m3x1m0m/SwakeUp/README.md

# SwakeUp
A device to wake you up in Sweden (because it is so dark in the winter).
