m3x1m0m/SwakeUp/documents/report/report.tex

%%%%%%%%%%%%%%%%%%%%%%%%%%%%%%%%%%%%%%%%%%%%%%%%%%%%%%%%%%%%%%%%%%%%%%%%%%%%%%%%%%%%%%
%% Author:      Maximilian Stiefel
%% Date:        31.05.2017
%% University:  Uppsala Universitet
%% Department:  Institutionen för informationsteknologi 
%% Course:      Programming Embedded Systems
%% Project:     Swakeup
%%%%%%%%%%%%%%%%%%%%%%%%%%%%%%%%%%%%%%%%%%%%%%%%%%%%%%%%%%%%%%%%%%%%%%%%%%%%%%%%%%%%%%

\documentclass{report}

%%%%%%%%%%%%%%%%%%%%%%%%%%%%%%%%%%%%%%%%%%%%%%%%%%%%%%%%%%%%%%%%%%%%%%%%%%%%%%%%%%%%%%
% Preamble
%%%%%%%%%%%%%%%%%%%%%%%%%%%%%%%%%%%%%%%%%%%%%%%%%%%%%%%%%%%%%%%%%%%%%%%%%%%%%%%%%%%%%%

% Encoding of the input
\usepackage[utf8]{inputenc}

% Geometry stuff
\usepackage[head=24pt,a4paper,lmargin={2.5cm},rmargin={2.5cm},tmargin={2.5cm},
bmargin={2.5cm}]{geometry}

% For graphics
\usepackage{graphicx}

% For code highlighting
\usepackage{minted}

% For shaded
\usepackage{xcolor}
\usepackage{framed}
\definecolor{shadecolor}{gray}{0.9}

% For some symbols
\usepackage{textcomp}
%\usepackage{eurosans}

% For math
\usepackage{amssymb}
\usepackage{amsmath}

\setlength{\parindent}{0em} 

% For title formatting 
\usepackage{titlesec} 

\titleformat%
{\chapter}%
[block]%
{\bfseries\Huge}%
{\thechapter\hspace{1cm}}%
{0pt}%
{\bfseries\Huge}%

% For SI units.
\usepackage{siunitx}

% Input definition macros
\input{mydefs.tex}

\usepackage{hyperref}
\hypersetup{
	plainpages=false,
	unicode=false,
	pdftoolbar=true,
	pdfmenubar=true,
	pdffitwindow=false,
	pdfstartview={FitH},
	pdftitle={\mytitle},
	pdfauthor={\myauthora ,\space\myauthorb ,\space\myauthorc},
	pdfsubject={\mytypeofwork\space\myduedate},
	pdfcreator={\myauthora ,\space\myauthorb ,\space\myauthorc},
	pdfproducer={\myauthora ,\space\myauthorb ,\space\myauthorc},
	pdfkeywords={\mykeywords},
	pdfnewwindow=true,
	pdfborder={0 0 0},
	colorlinks=false,
	linkcolor=black,
	citecolor=black,
	filecolor=black,
	urlcolor=cyan
}	

\newcommand{\newpar}{\vspace{1em}\\}
\newcommand{\myemph}[1]{\textsl{#1}}

% For PDFs
\usepackage{pdfpages}

% Header and footer
\usepackage{fancyhdr}
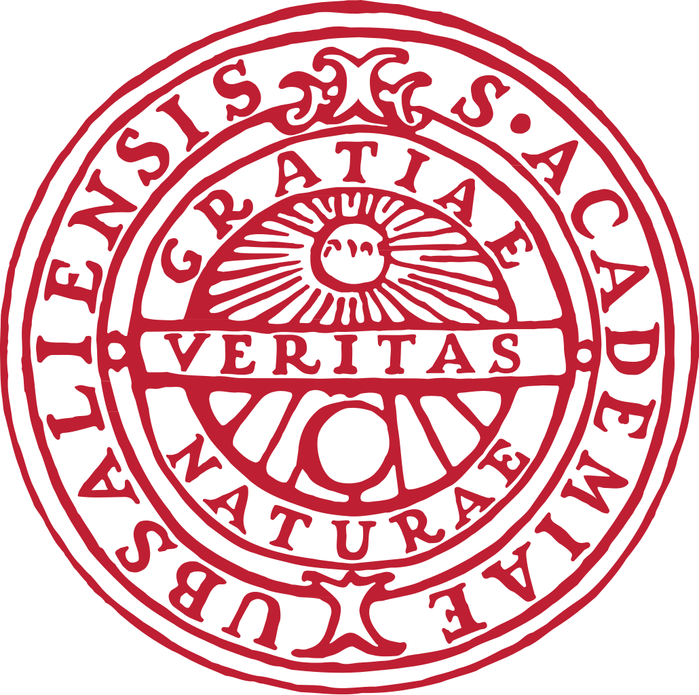
[picture p1: documents/report/fig/uppsla_university.png]
\lhead{\ifnum\value{chapter}>0  \fi}
\chead{}
\rhead{\ifnum\value{chapter}>0 {\rightmark}\\\textcolor{gray}{\leftmark} \fi}
\lfoot{}
\cfoot{\ifnum\value{chapter}>0 \thepage \fi}
\rfoot{}
\setlength{\headheight}{1cm}

% For quotes
\usepackage[autostyle]{csquotes}
\usepackage[style=ieee,backend=bibtex]{biblatex}
\addbibresource{literature.bib}

%For tables
\usepackage{tabularx}

\begin{document}

%%%%%%%%%%%%%%%%%%%%%%%%%%%%%%%%%%%%%%%%%%%%%%%%%%%%%%%%%%%%%%%%%%%%%%%%%%%%%%%%%%%%%%
% Titlepage
%%%%%%%%%%%%%%%%%%%%%%%%%%%%%%%%%%%%%%%%%%%%%%%%%%%%%%%%%%%%%%%%%%%%%%%%%%%%%%%%%%%%%%
\input{titlepage.tex}

\newcounter{roman}
\pagenumbering{Roman}

\pagestyle{fancy}

%%%%%%%%%%%%%%%%%%%%%%%%%%%%%%%%%%%%%%%%%%%%%%%%%%%%%%%%%%%%%%%%%%%%%%%%%%%%%%%%%%%%%%
% TOC etc.
%%%%%%%%%%%%%%%%%%%%%%%%%%%%%%%%%%%%%%%%%%%%%%%%%%%%%%%%%%%%%%%%%%%%%%%%%%%%%%%%%%%%%%
\tableofcontents
\listoffigures
\newpage
\listoftables

\newpage
\setcounter{roman}{\value{page}}
\pagenumbering{arabic}
\setcounter{page}{1}

%%%%%%%%%%%%%%%%%%%%%%%%%%%%%%%%%%%%%%%%%%%%%%%%%%%%%%%%%%%%%%%%%%%%%%%%%%%%%%%%%%%%%%
% Introduction
%%%%%%%%%%%%%%%%%%%%%%%%%%%%%%%%%%%%%%%%%%%%%%%%%%%%%%%%%%%%%%%%%%%%%%%%%%%%%%%%%%%%%%

\input{./doc/introduction.tex}

%%%%%%%%%%%%%%%%%%%%%%%%%%%%%%%%%%%%%%%%%%%%%%%%%%%%%%%%%%%%%%%%%%%%%%%%%%%%%%%%%%%%%%
% Background and Analysis
%%%%%%%%%%%%%%%%%%%%%%%%%%%%%%%%%%%%%%%%%%%%%%%%%%%%%%%%%%%%%%%%%%%%%%%%%%%%%%%%%%%%%%

\input{./doc/background.tex}

%%%%%%%%%%%%%%%%%%%%%%%%%%%%%%%%%%%%%%%%%%%%%%%%%%%%%%%%%%%%%%%%%%%%%%%%%%%%%%%%%%%%%%
% Design
%%%%%%%%%%%%%%%%%%%%%%%%%%%%%%%%%%%%%%%%%%%%%%%%%%%%%%%%%%%%%%%%%%%%%%%%%%%%%%%%%%%%%%

\input{./doc/design.tex}

%%%%%%%%%%%%%%%%%%%%%%%%%%%%%%%%%%%%%%%%%%%%%%%%%%%%%%%%%%%%%%%%%%%%%%%%%%%%%%%%%%%%%%
% Implementation
%%%%%%%%%%%%%%%%%%%%%%%%%%%%%%%%%%%%%%%%%%%%%%%%%%%%%%%%%%%%%%%%%%%%%%%%%%%%%%%%%%%%%%

\input{./doc/implementation.tex}

%%%%%%%%%%%%%%%%%%%%%%%%%%%%%%%%%%%%%%%%%%%%%%%%%%%%%%%%%%%%%%%%%%%%%%%%%%%%%%%%%%%%%%
% Evaluation
%%%%%%%%%%%%%%%%%%%%%%%%%%%%%%%%%%%%%%%%%%%%%%%%%%%%%%%%%%%%%%%%%%%%%%%%%%%%%%%%%%%%%%

\input{./doc/evaluation.tex}

%%%%%%%%%%%%%%%%%%%%%%%%%%%%%%%%%%%%%%%%%%%%%%%%%%%%%%%%%%%%%%%%%%%%%%%%%%%%%%%%%%%%%%
% Conclusion
%%%%%%%%%%%%%%%%%%%%%%%%%%%%%%%%%%%%%%%%%%%%%%%%%%%%%%%%%%%%%%%%%%%%%%%%%%%%%%%%%%%%%%

\input{./doc/conclusion.tex}

%%%%%%%%%%%%%%%%%%%%%%%%%%%%%%%%%%%%%%%%%%%%%%%%%%%%%%%%%%%%%%%%%%%%%%%%%%%%%%%%%%%%%%
% Bibliography and Appendix
%%%%%%%%%%%%%%%%%%%%%%%%%%%%%%%%%%%%%%%%%%%%%%%%%%%%%%%%%%%%%%%%%%%%%%%%%%%%%%%%%%%%%%

\clearpage
\pagenumbering{Roman}
\setcounter{page}{\value{roman}}
\pagestyle{empty}

\printbibliography[heading=bibintoc]

%%%%%%%%%%%%%%%%%%%%%%%%%%%%%%%%%%%%%%%%%%%%%%%%%%%%%%%%%%%%%%%%%%%%%%%%%%%%%%%%%%%%%%
% Appendix
%%%%%%%%%%%%%%%%%%%%%%%%%%%%%%%%%%%%%%%%%%%%%%%%%%%%%%%%%%%%%%%%%%%%%%%%%%%%%%%%%%%%%%
\appendix
% Introduce new geometry to be able to have more space for appendix
\newgeometry{lmargin={2.5cm},rmargin={2.5cm},tmargin={0cm},bmargin={1,5cm}}
\includepdf[pages={1},scale=0.8,pagecommand=\chapter{Schematics Logic Board}\label{append:logic}]{./fig/logic.pdf}
\includepdf[pages={1},scale=0.8,pagecommand=\chapter{Schematics Power Board}\label{append:power}]{./fig/power.pdf}
\includepdf[pages={2-},scale=0.8,pagecommand={}]{./fig/power.pdf}
\chapter{USART interrupt generation}
\label{append:usartinterruptgen}
\begin{minted}[baselinestretch=1, fontsize=\small, linenos,frame=single,framesep=5pt]{C}
#define USARTRXCISR(NAME, PORT, USART_ID, REC_FC)            \
ISR(NAME##_RXC_vect) {                             \
	uint8_t read = PORT.DATA;                    \
	if (writeInBuf(read, &PORT)) {               \
	REC_FC(read);                                   \
	uint8_t i = 0;                              \
	for (; i < UART_MAX_DELIMITERS; i++) {      \
		if (delimiters[USART_ID][i].delimiter != 0) {  \
			delimiters[USART_ID][i].length++;          \
			if (read == delimiters[USART_ID][i].delimiter) {   \
				delimiters[USART_ID][i].port = &PORT;       \
				event_fire(&EVENT_UART_DELIMITER,	\
				SYSTEM_ADDRESS_CAST (&delimiters[USART_ID][i])); \
				}   \
			}   \
		}   \
	} else {/*buffer full */    \
		CP_PORT.CTRLA &= ~(USART_RXCINTLVL_LO_gc);  \
	}   \
}

#define USARTDREISR(NAME, PORT, USART_ID)\
ISR(NAME##_DRE_vect) {             \
	uint8_t size = uartStatus[USART_ID].outBuffer_size;    \
	if (size > 0) { \
		if (softlock(USART_ID)) {\
			uint8_t tail = uartStatus[USART_ID].outBuffer_tail;\
			PORT.DATA = outBuffer[USART_ID][tail];  \
			uartStatus[USART_ID].outBuffer_size--; \
			tail++; \
			if (tail >= UART_MAX_OUT_BUFFER) tail = 0;\
			uartStatus[USART_ID].outBuffer_tail = tail;\
			unlock(USART_ID);  \
		}\
	} else {\
		sending[USART_ID] = 0;\
		PORT.CTRLA &= ~(USART_DREINTLVL0_bm);\
	}\
}
\end{minted}
\end{document}
