m3x1m0m/SwakeUp/documents/proposal/doc/outlook.tex

Hopefully the LED driver will work with the next revision. The new boards have not arrived until the deadline. As soon as the hardware is working, the controllers will be implemented in software. 
\newpar
Aditional funtionality will be implemented e.g. connecting you calendar to the device and seing your daily agenda when you wake up. Also there is no housing yet.
