m3x1m0m/SwakeUp/documents/proposal/doc/works.tex

The hardware right now is in revision 2.0. There has been one revision before the current one. This revision has been fabricated in january 2017 and the design process began in november 2016. There were some mistakes on the first hardware revision, which were not fixable so easily, especially because of the fact, that everything is quite small. Table \ref{tab:hw} gives an overview of the current satus of the hardware.   
\begin{table}[H]
\centering
\begin{tabular}{lll}
\textbf{HW Block}  	& \textbf{Working}& \textbf{Problem}  	\\\hline
USB Charging 	& \checkmark	& 				\\
OLED Driver  	& \checkmark    & 				\\
Vcc for µC   	& \checkmark    & 				\\
IEEE 802.11   	& \checkmark    &                             	\\
USB2UART	& \checkmark	&				\\
LED Driver	&		& Wrong footprint assignment	\\
Crystal		&		& Wrong pin assignment		\\
USB DCP		&		& Further tests necessary	\\
\end{tabular}
\caption{Hardware Overview: What works? What does not?}
\label{tab:hw}
\end{table}
Table \ref{tab:sw} deals with an overview about the status of the software. 
\begin{table}[H]
\centering
\begin{tabular}{lll}
\textbf{SW Block}  	& \textbf{Working}& \textbf{Problem} 	\\\hline
UART 		& \checkmark	& 				\\
SPI	  	& \checkmark    & 				\\
EPROM   	& \checkmark    & 				\\
Timer   	& \checkmark    &                             	\\
ADC		& 		& 				\\
PWM 		&		&				\\
ESP8266		& \checkmark	& 				\\
Terminal	& \checkmark	& 				\\
SEP525F		& \checkmark	& 				\\
Wifi		& 		& 				\\
Command		& \checkmark	& 				\\
Log		& \checkmark	& 				\\
Screen		& \checkmark	& 				\\
Timekeeper	& \checkmark	& 				\\
Controller	&		&				\\
Core		& \checkmark	& 				\\
Weather		& \checkmark	&				\\
Clock		& \checkmark	&				\\
Social		& 		&				\\
\end{tabular}
\caption{Software Overview: What works? What does not?}
\label{tab:sw}
\end{table}
