m3x1m0m/SwakeUp/documents/presentation/presentation.tex

\documentclass[apectratio=169]{beamer}
\usetheme{metropolis}           % Use metropolis theme
% For PDFs
\usepackage{pdfpages}
\usepackage{minted}
\usepackage{tabularx}
\title{Swakeup}
\subtitle{More Than A Simple Wakeup Light}
\date{\today}
\author{Elmar van Rijnswou and Maximilian Stiefel}
\institute{Uppsala University}
\begin{document}
  \maketitle

\begin{frame}{Table Of Contents}
  \setbeamertemplate{section in toc}[sections numbered]
  \tableofcontents[hideallsubsections]
\end{frame}

  \section{Introduction}
  	\begin{frame}{Poka-yoke}
		\only<1>{\Large Who knows what Poka-yoke is?}
		\only<2>{
		\metroset{block=fill}
		\begin{block}{Poka-yoke (Wikipedia)}
		Poka-yoke [poka joke] is a Japanese term that means
		"mistake-proofing" or "inadvertent error prevention".
		\end{block}
		}
	\end{frame}
	\begin{frame}{Background}
		\begin{figure}
        		\centering
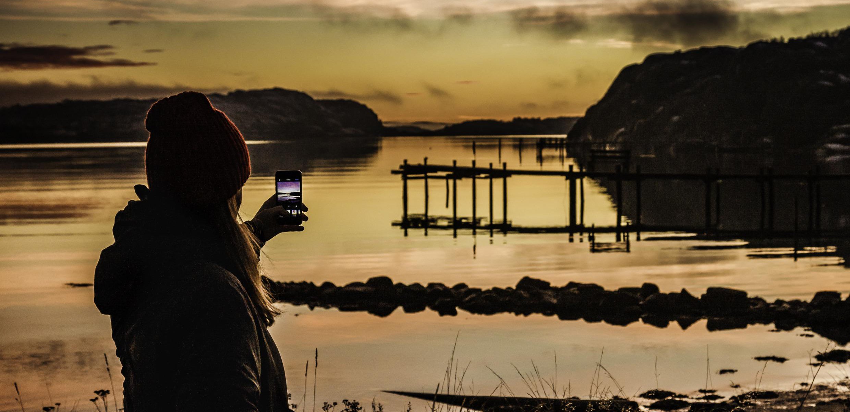
[picture p9: documents/presentation/fig/darkness.jpg]
                	
			\caption{According to Sveriges Radio ”many Swedes suffer
		from the winter blues or seasonal affective disorder”.
		Image Source: Visitsweden}
		\end{figure}
	\end{frame}

  	\begin{frame}{System Requirements}
		\begin{itemize}
			\item<1-> Wakeup light which is a part of the \textit{IoT}
			\item<2-> Swakeup \ensuremath{\rightarrow} engl. "Swedish Wakeup Light"
			\item<3-> Wakes up, displays time, weather, mails, facebook
			\item<4-> Smart, small, USB charger included
			\item<5-> \alert<5->{Spends happiness}
		\end{itemize}
  	\end{frame}
  	\begin{frame}{System Overview}	
		\begin{figure}
			\centering
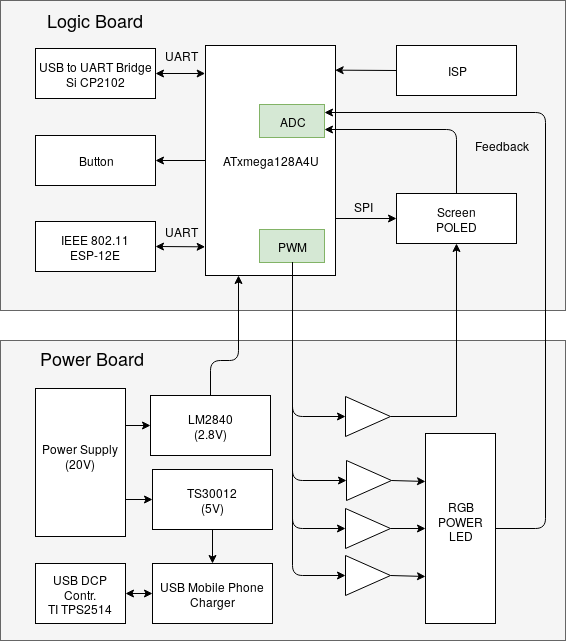
[picture p10: documents/block/block.png]
			\only<2>{}
			\only<1>{}
			\caption{System Overview}
		\end{figure}
	\end{frame}
  
  \section{Hardware}
  	\begin{frame}{Power Board}
		\begin{figure}
			\centering
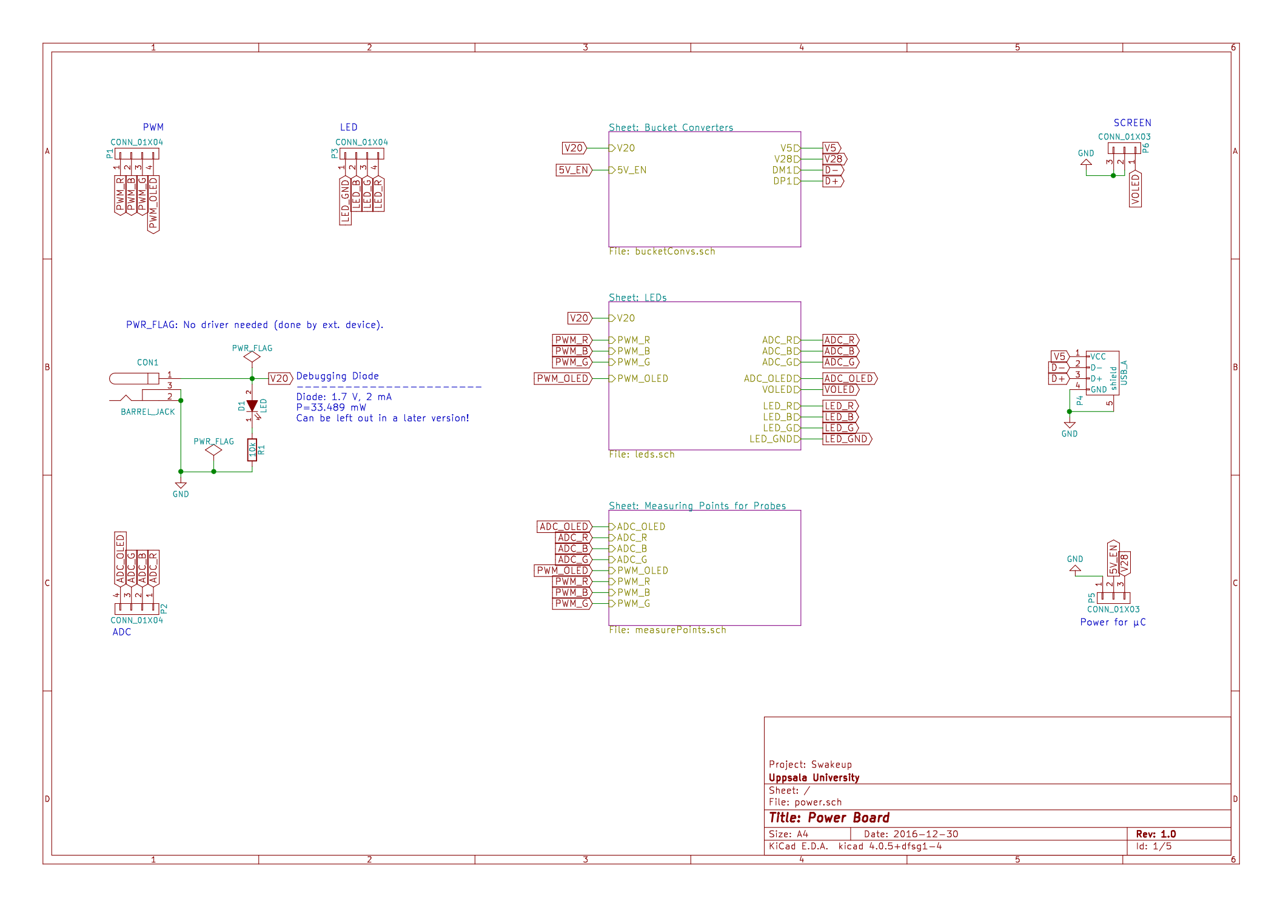
[picture p11: documents/presentation/fig/power1.png]
			\only<1>{}
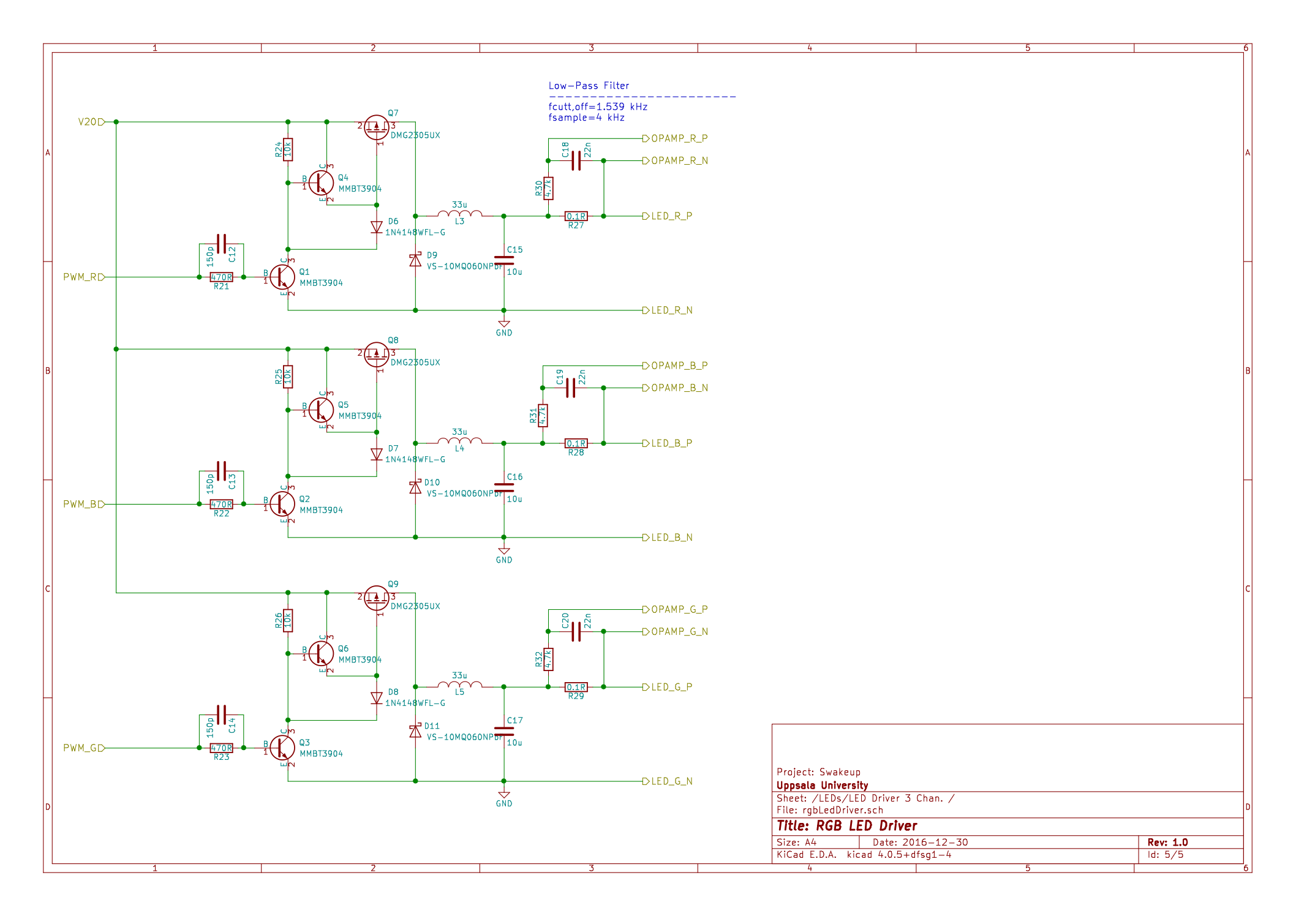
[picture p12: documents/presentation/fig/power2.png]
			\only<2>{}
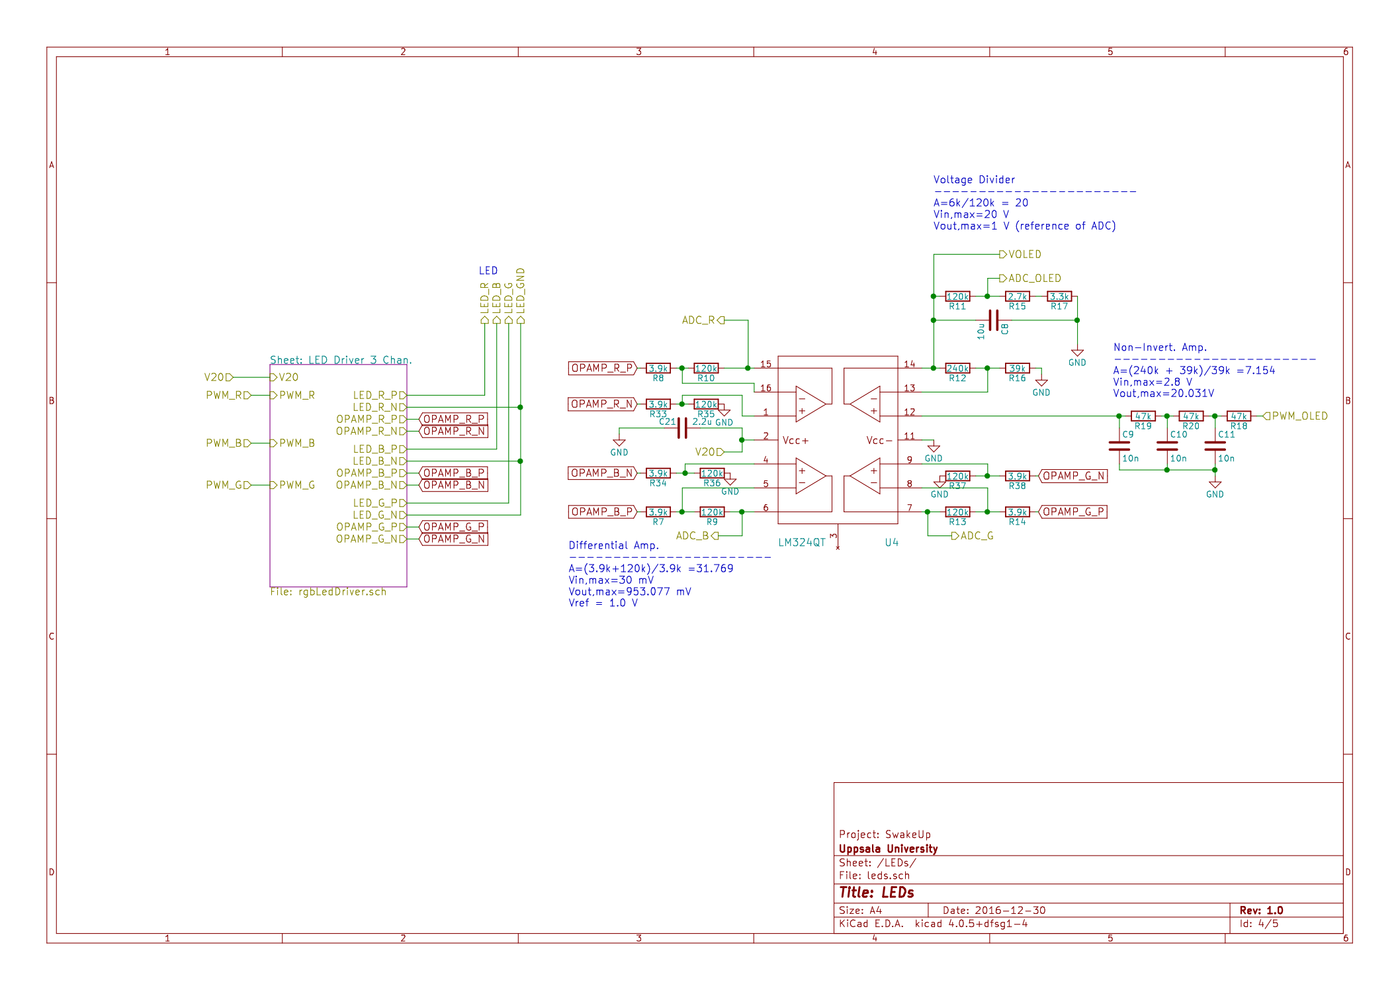
[picture p13: documents/presentation/fig/power3.png]
			\only<3>{}

			\caption{Power Board Schematics}
		\end{figure}	
  	\end{frame}
  	\begin{frame}{Logic Board}	
		\begin{figure}
			\centering
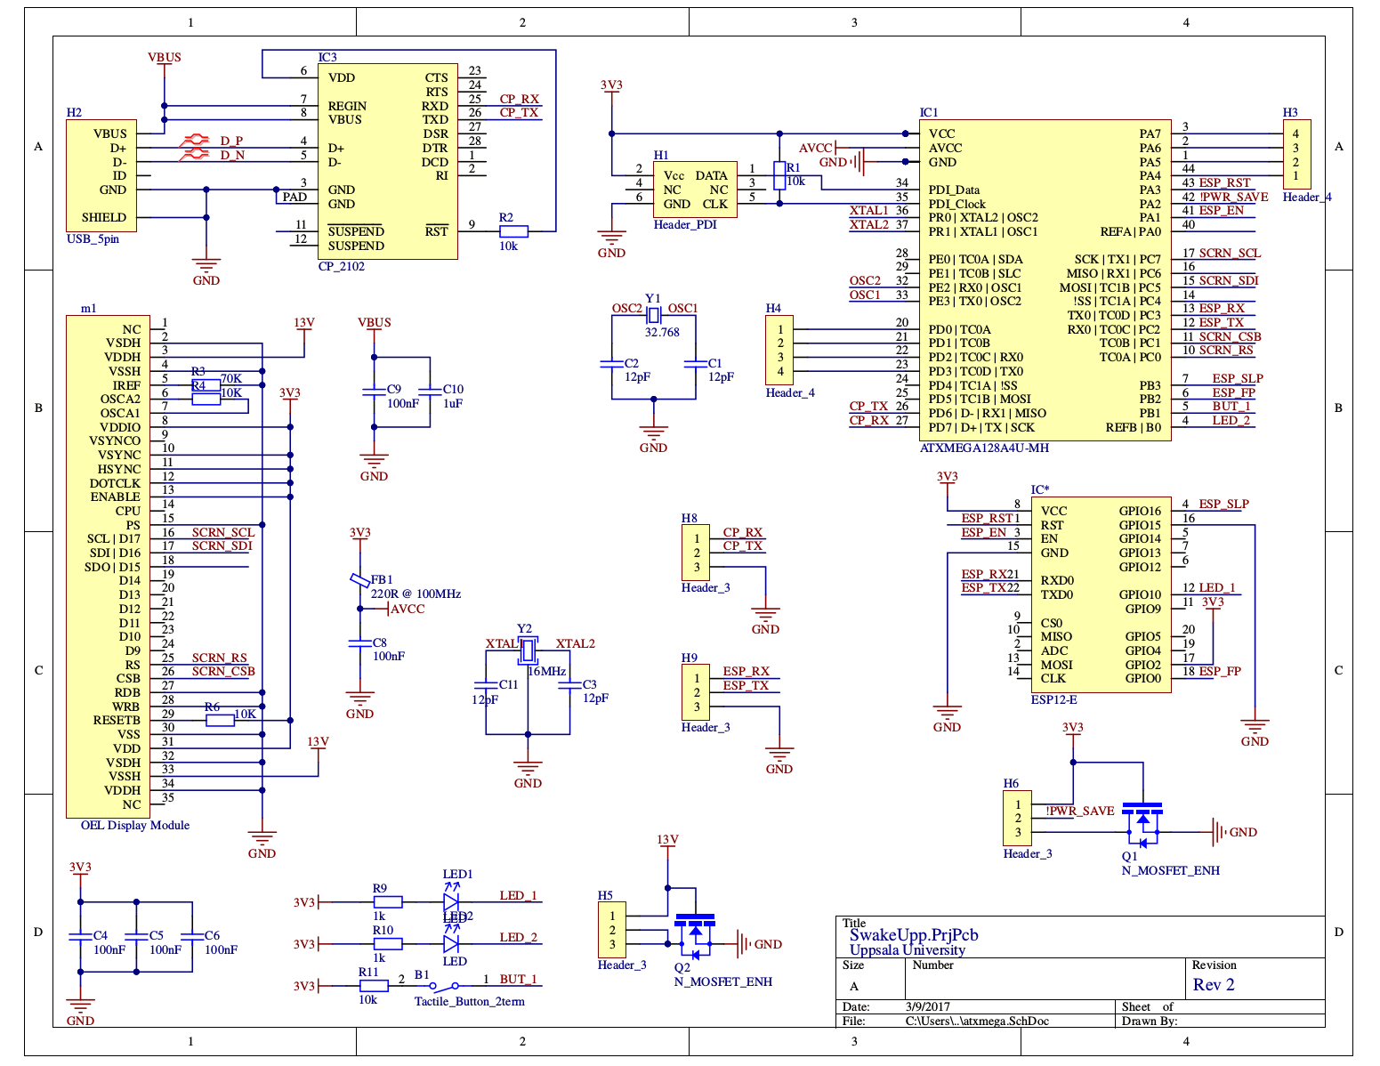
[picture p14: documents/presentation/fig/logic.png]
			
			\caption{Logic Board Schematics}
		\end{figure}
	\end{frame}

  \section{Software}
  	\begin{frame}{Code Structure}
		 \begin{figure}
                        \centering
                        
                        \caption{Abstract Layering Model}
                \end{figure}
  	\end{frame}
	\begin{frame}{Code Organisation}
		 \begin{figure}
                        \centering
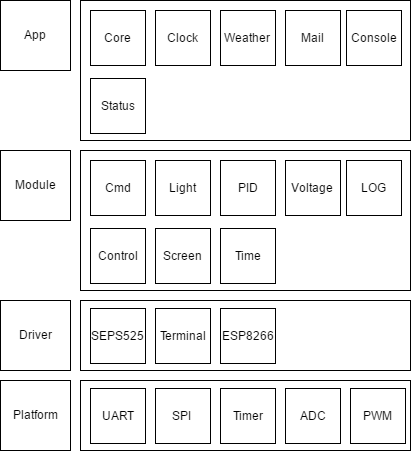
[picture p15: documents/presentation/fig/block_code.png]
                        
                        \caption{Block Diagram Of The Code Organisation}
                \end{figure}
  	\end{frame}

\begin{frame}[fragile]{Operating System - Modules And Events}
\begin{minted}[baselinestretch=1, fontsize=\tiny, linenos,frame=single,framesep=5pt]{C}
#define MODULE_DEFINE(VAR, DESC, INIT, DEINIT, ...)     \
        Module VAR = {                                  \
                .init = INIT,                           \
                .deinit = DEINIT,                       \
                .cnt = 0,                               \
                .name = DESC,                           \
                .deps = { __VA_ARGS__ }                 \
        }
MODULE_DEFINE(CORE, "Central core", init, deinit, &TIME, &COMMAND, &ESP8266);
\end{minted}

\begin{minted}[baselinestretch=1, fontsize=\tiny, linenos,frame=single,framesep=5pt]{C}
#define EVENT_REGISTER(eventName, desc)\
        Event eventName = \
        {.eventId = __COUNTER__, .data = 0, .description = desc, .descLen = sizeof(desc) }
EVENT_REGISTER(EVENT_UART_DELIMITER, "Got UART delimiter");
\end{minted}

\begin{minted}[baselinestretch=1, fontsize=\tiny, linenos,frame=single,framesep=5pt]{C}
event_addListener(&EVENT_UART_DELIMITER, callback);
\end{minted}

\begin{minted}[baselinestretch=1, fontsize=\tiny, linenos,frame=single,framesep=5pt]{C}
event_fire(&EVENT_UART_DELIMITER, SYSTEM_ADDRESS_CAST (&delimiters[USART_ID][i]));
\end{minted}

\end{frame}	

\begin{frame}[fragile]{Drivers- ADC}
\begin{minted}[baselinestretch=1, fontsize=\tiny, linenos,frame=single,framesep=5pt]{C}
/////////////////////////////////////////////////////////////////////////////////
// Macro: Create ISRs for the individual channels.
/////////////////////////////////////////////////////////////////////////////////
#define CREATE_ADCA_ISR(ADCVECTOR, VARSEMAPHORE, BUFFER, RESULTREG,STARTFLAG) \
ISR(ADCVECTOR) \
{ \
        static volatile uint8_t cycles = 0; \
        if(!VARSEMAPHORE) \
        { \
                if( ((int16_t) RESULTREG) < 0) \
                        BUFFER[cycles++] = 0; \
                else \
                        BUFFER[cycles++] = RESULTREG; \
                if(cycles < NU_AVERAGING_VALS) \
                ADCA.CTRLA |= STARTFLAG; \
                else\
                {\
                        VARSEMAPHORE= 1;\
                        cycles = 0;\
                }\
        }\
}

\end{minted}
\end{frame}
	\begin{frame}{Realization (1)}
	\begin{figure}
        	\centering
                
                \caption{Screen Logging}
        \end{figure}
	\end{frame}

	\begin{frame}{Realization (2)}
	\begin{figure}
        	\centering
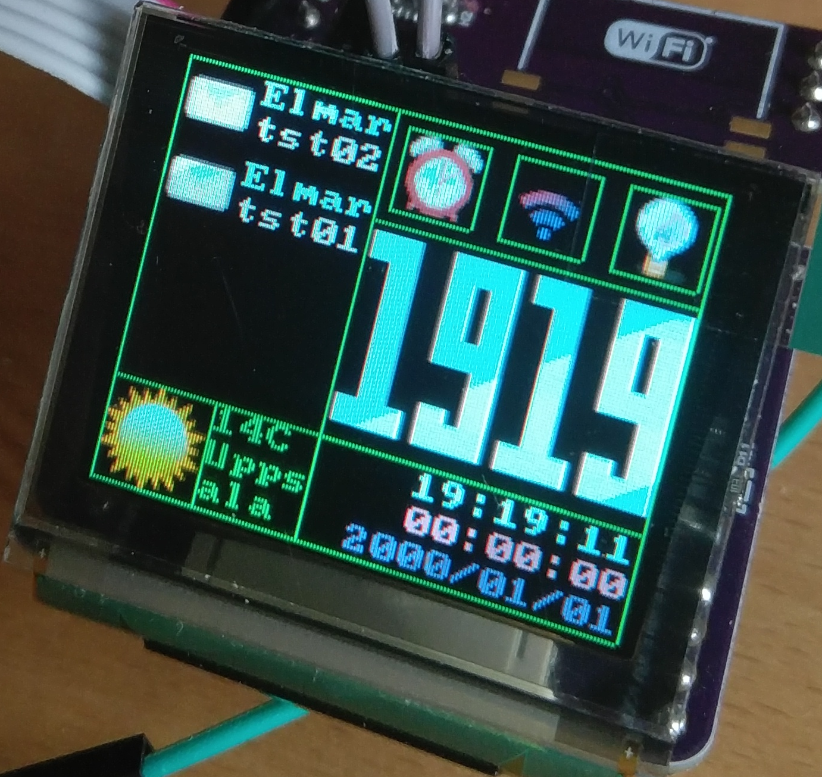
[picture p16: documents/presentation/fig/clock_weather.png]
                
                \caption{Appearence Of The Clock}
        \end{figure}
	\end{frame}
	
	\begin{frame}{Realization (3)}
	\begin{figure}
        	\centering
                
                \caption{USART Command Interpreter}
        \end{figure}
	\end{frame}

\begin{frame}{Realization (4)}
	\begin{figure}
        	\centering
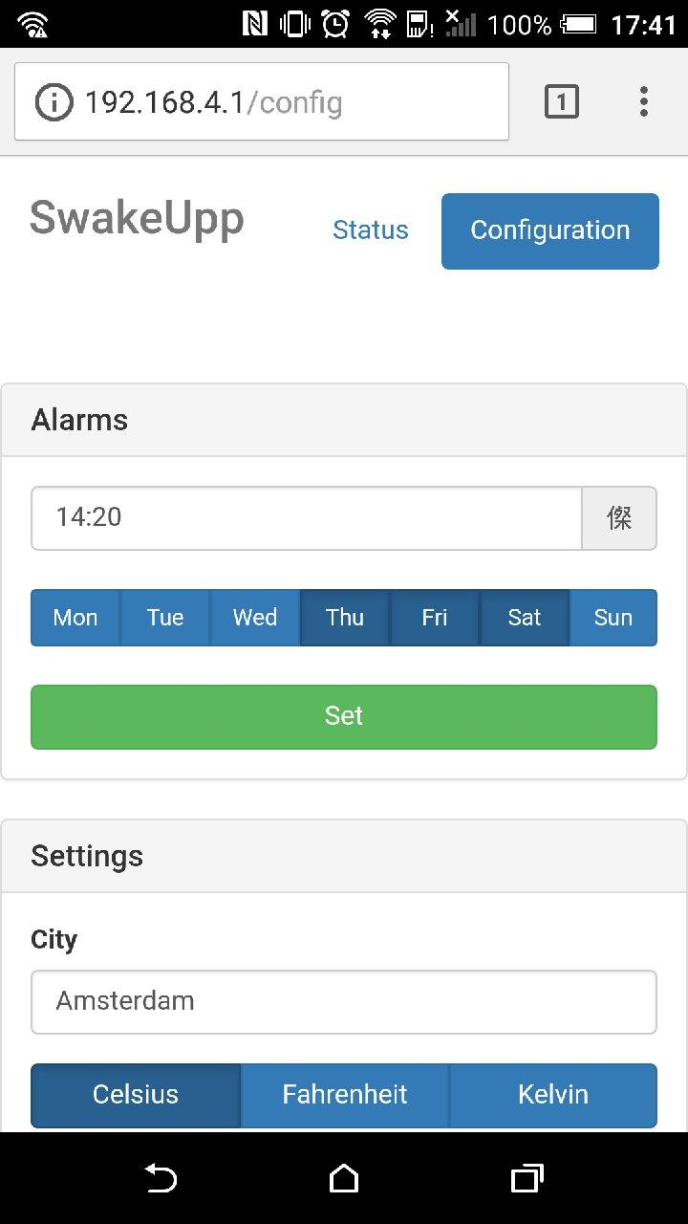
[picture p17: documents/presentation/fig/website1.jpg]
		\only<1>{}
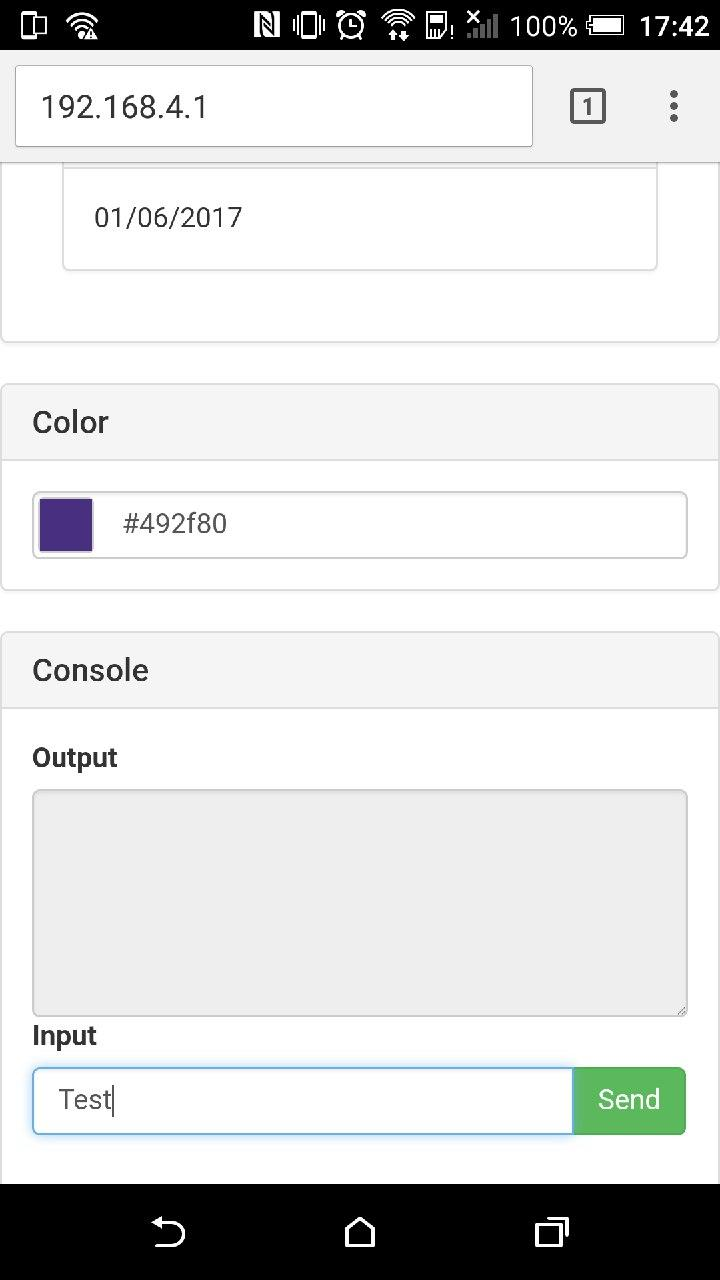
[picture p18: documents/presentation/fig/website2.jpg]
                \only<3>{}
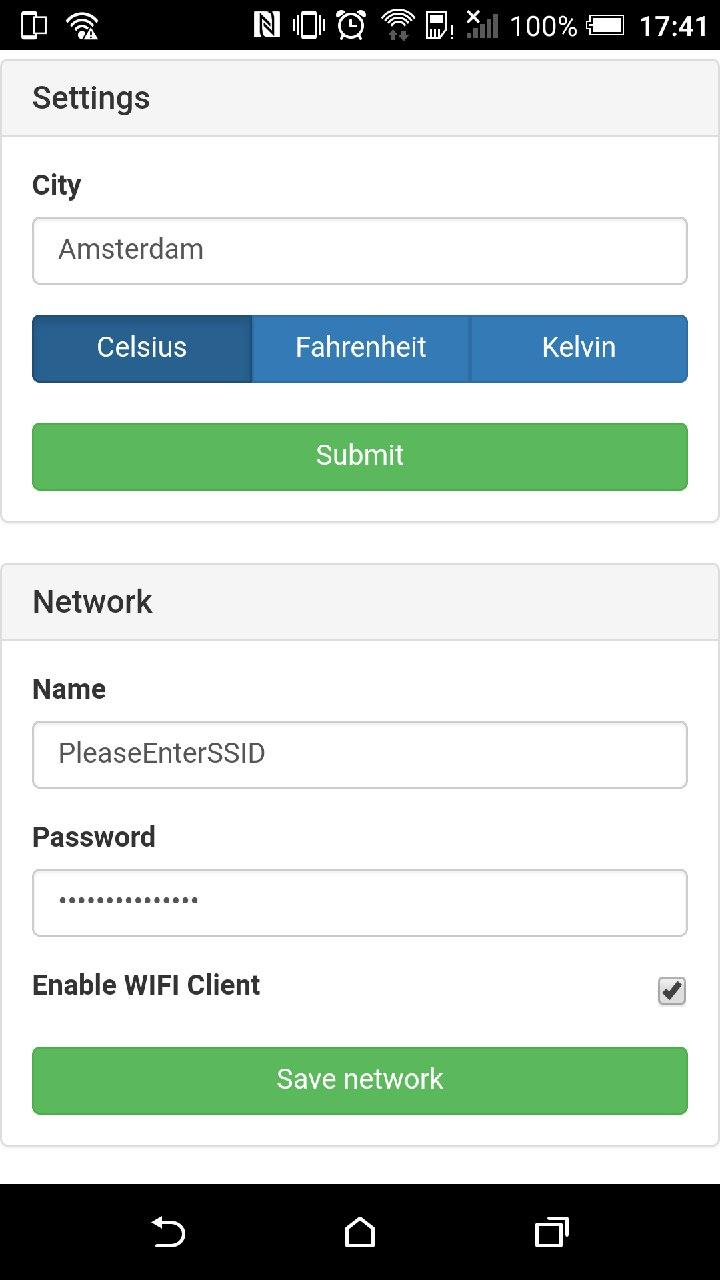
[picture p19: documents/presentation/fig/website3.jpg]
		\only<2>{}
		\caption{Website: Main User Interface}
        \end{figure}
	\end{frame}

  \section{Status Quo and Outlook}
	\begin{frame}{Basic System Functionality is Given}
	\begin{figure}
        	\centering
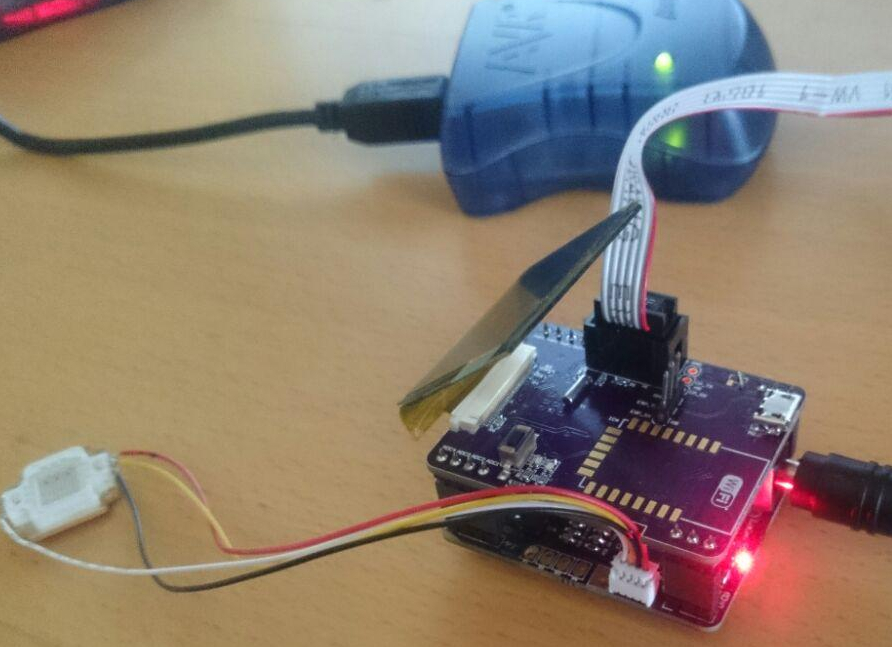
[picture p20: documents/presentation/fig/demo.jpg]
                
                \caption{Picture of Nake HW}
        \end{figure}
	\end{frame}

	\begin{frame}{Hardware} \footnotesize \begin{table}[H] \centering
		\begin{tabularx}{\textwidth}{llX} \textbf{HW Block} &
			\textbf{Working}& \textbf{Problem} \\\hline USB Charging
			& \checkmark & \\ Screen Driver & \checkmark & \\ Screen
			Driver Feedback& \checkmark & \\ Vcc for µC & \checkmark
			& \\ ESP & \checkmark & \\ Terminal & \checkmark & \\
			LED Driver & \checkmark & \\ LED Driver Feedback & &
			Reversed inputs of the differential ampifier \\ USB DCP
			& \checkmark & \\ Reverse Polarity Protection &
		\checkmark & \\ \hline \end{tabularx} \caption{Status Quo
	Hardware} \label{tab:hw_status_quo} \end{table} \end{frame}

	\begin{frame}{Software}
	\tiny
		\begin{table}[H] \centering \begin{tabularx}{\textwidth}{llX}
			\textbf{SW Block} & \textbf{Working}& \textbf{Problem}
			\\\hline UART & \checkmark & \\ SPI & \checkmark & \\
			EPROM & \checkmark & \\ Timer & \checkmark & \\	ESP8266
			& \checkmark & \\ Terminal & \checkmark & \\ SEP525F &
			\checkmark & \\ Wifi & \checkmark & \\ Command &
			\checkmark & \\ Log & \checkmark & \\ Screen &
			\checkmark & \\ Timekeeper & \checkmark & \\ Controller
			& & \\ Core & \checkmark & \\ Weather & \checkmark & \\
			Clock & \checkmark & \\ Social & & Not implemented yet
			\\ PWM & \checkmark & \\ ADC & \checkmark & \\
			Lightcontroller & \checkmark & \\ PID & \checkmark & \\
			Advanced Light Patterns & & Debugging still ongoing\\
		Play 8 bit sounds & & Not implemented, HW missing\\ \hline
		\end{tabularx} \caption{Status Quo Software}
	\label{tab:sw_status_quo} \end{table}
	\end{frame}
	
  	\begin{frame}{Outlook}	
		\begin{itemize}
			\item<1-> HW revision 3 is under construction
			\item<2-> Different functionality shall be added
			\item<3-> Housing will be constructed
			\item<4-> Social connectivity and calendar functions will be implemented
			\item<5-> Take part in Swedish Embedded Award (Embedded
				Priset)
		\end{itemize}
	\end{frame}

  	\begin{frame}{Open Source}
        	\begin{center}
                \begin{table}[]
                        \begin{tabular}{ll}
                                E: & Elmar.Vanrijnswou.9818@student.uu.se \\
                                E: & Maximilian.Stiefel.8233@student.uu.se\\
                        \end{tabular}
                \end{table}
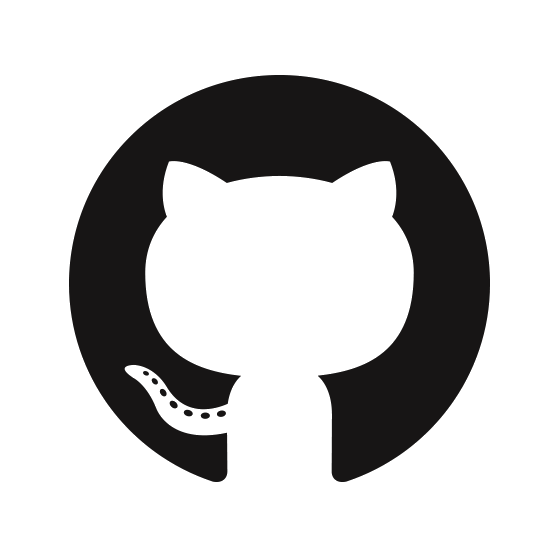
[picture p21: documents/presentation/fig/github.png]
                 \hspace{0.1cm} \url{github.com/m3x1m0m/SwakeUp}\\
        	\end{center}
        	\begin{figure}
                	
        	\end{figure}
  	\end{frame}

  \begin{frame}[standout]
	Happy Coding :) 
  \end{frame}
\end{document}
