m3x1m0m/SwakeUp/documents/presentation/presentation.pdf

## Swakeup

More Than A Simple Wakeup Light

Elmar van Rijnswou and Maximilian Stiefel

March 14, 2017

Uppsala University

Table Of Contents

1. Introduction
2. Hardware
3. Software
4. Status Quo and Outlook

## Introduction

The Idea

- Wakeup light which is a part of the IoT

The Idea

- Wakeup light which is a part of the IoT
- Swakeup → engl. ”Swedish Wakeup Light”

The Idea

- Wakeup light which is a part of the IoT
- Swakeup → engl. ”Swedish Wakeup Light”
- Wakes up, displays time, weather, mails, facebook

The Idea

- Wakeup light which is a part of the IoT
- Swakeup → engl. ”Swedish Wakeup Light”
- Wakes up, displays time, weather, mails, facebook
- Smart, small, USB charger included

System Overview

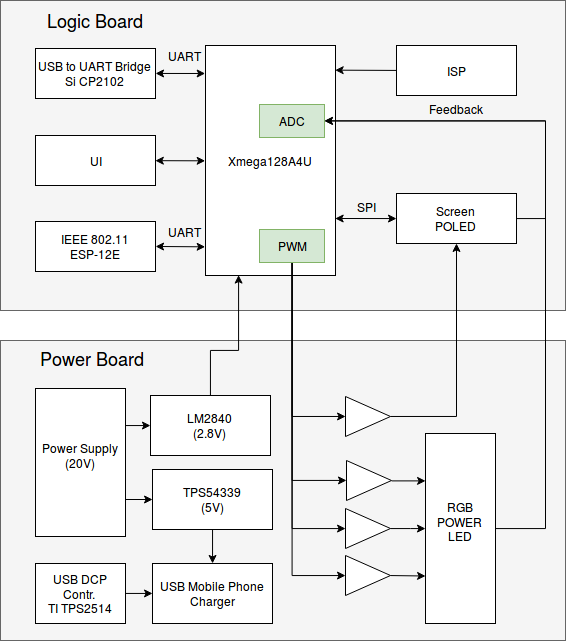
[picture p31: figure]

Figure 1: System Overview | 3

## Hardware

Power Board

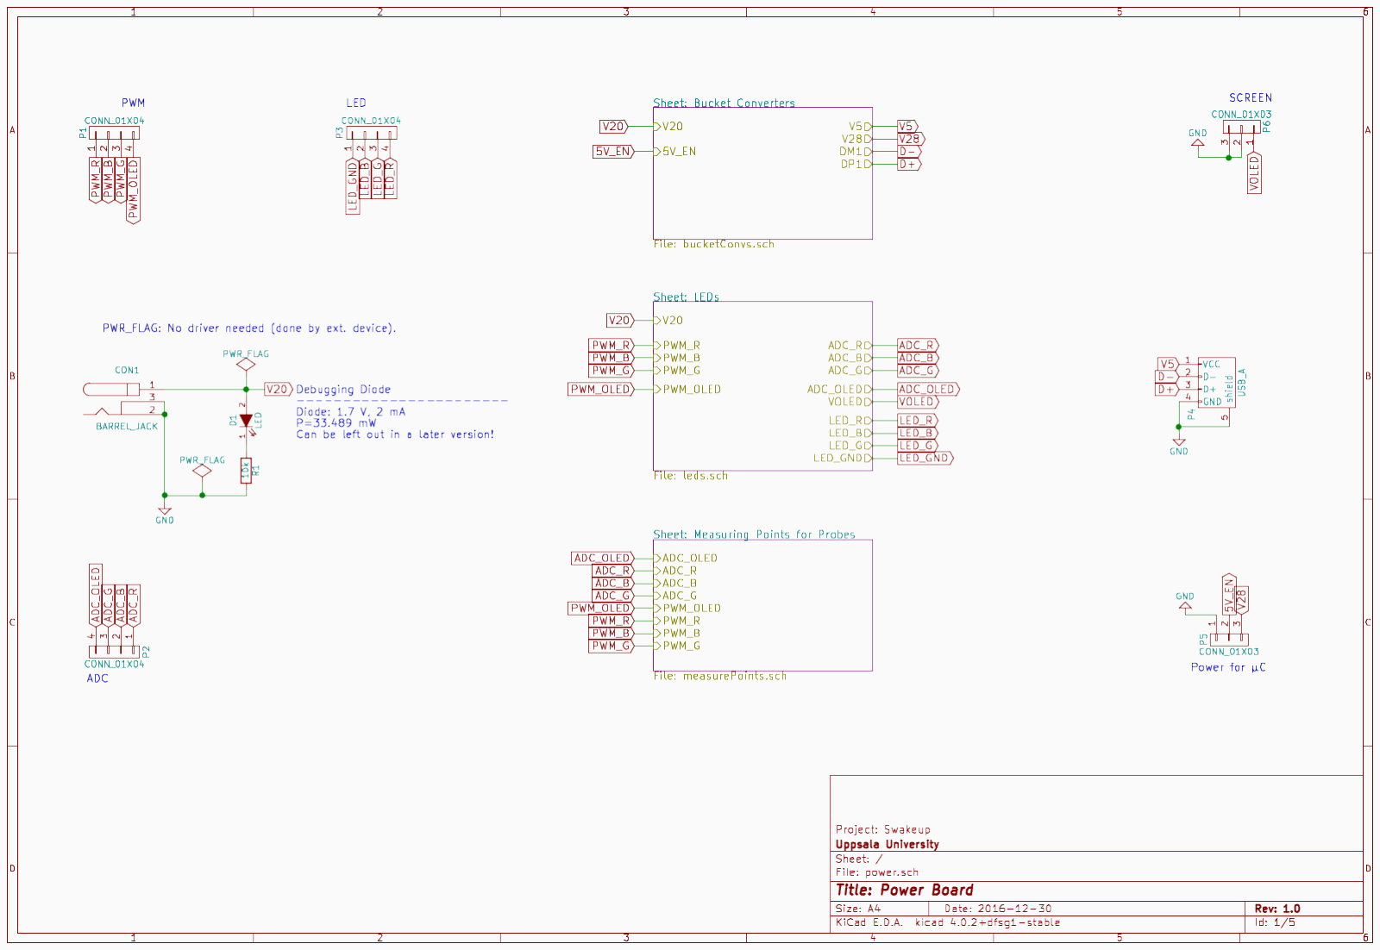
[picture p32: figure]

Figure 2: Top View Of The Power Board Schematics | 4

Logic Board

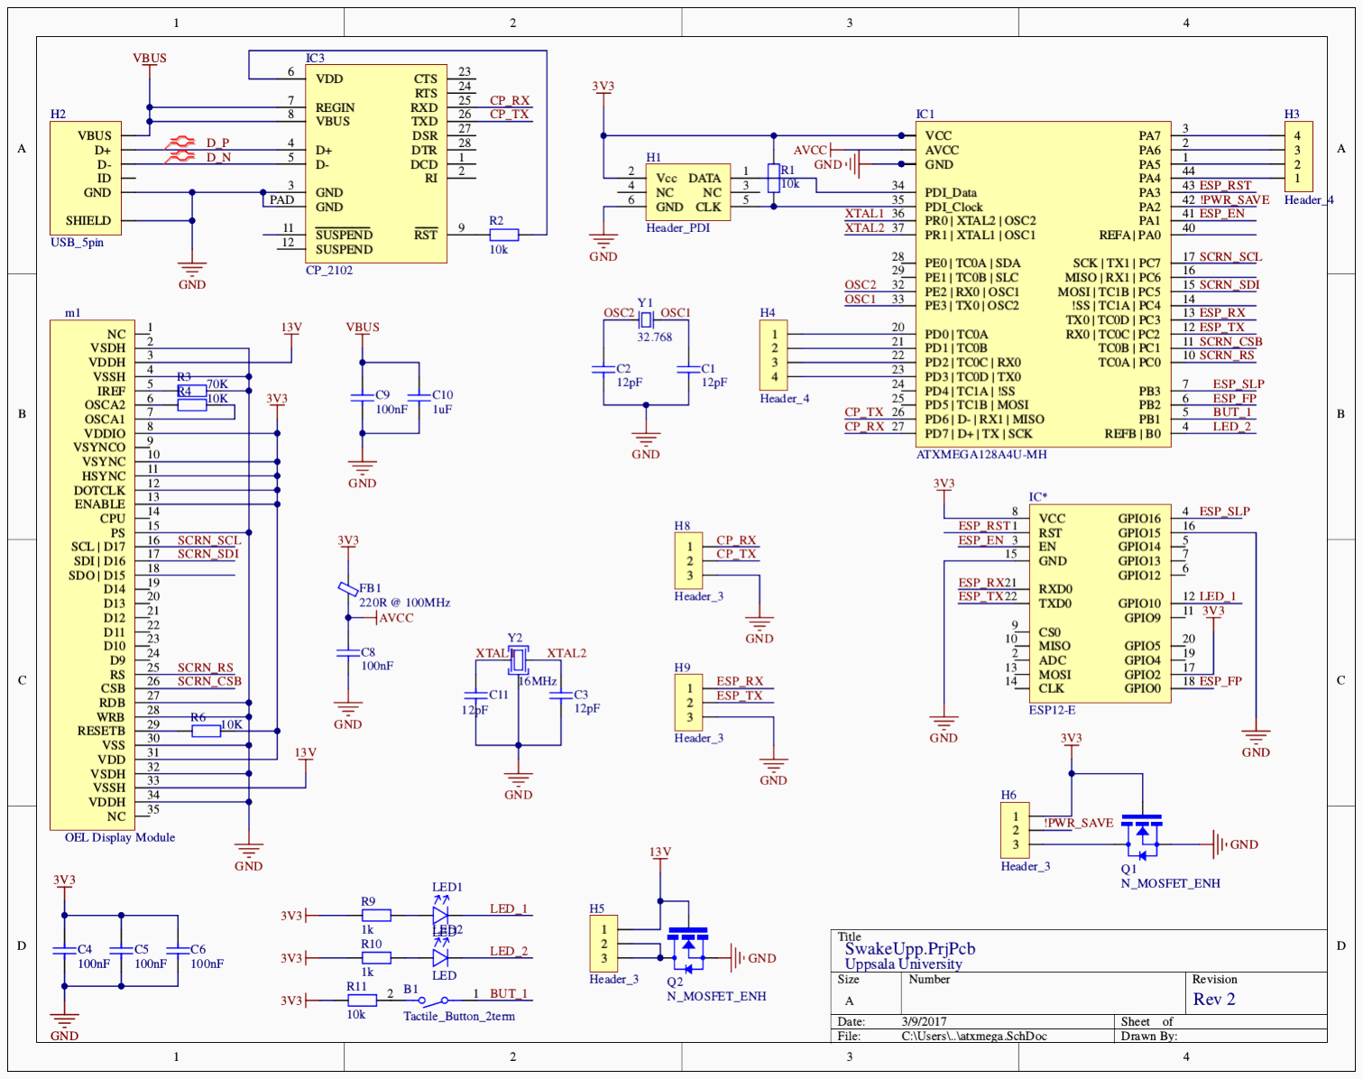
[picture p33: figure]

Figure 3: Logic Board Schematics | 5

## Software

Code Structure

Figure 4: Abstract Layering Model

Code Organisation

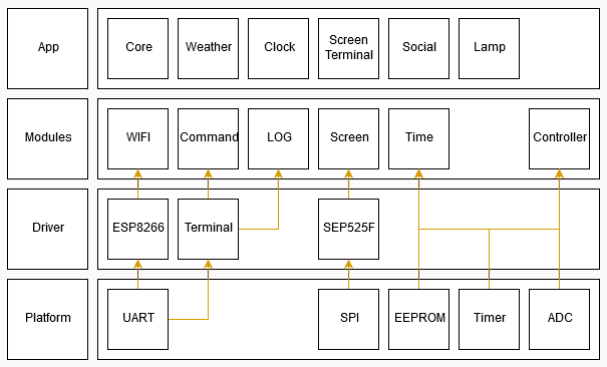
[picture p34: figure]

Figure 5: Block Diagram Of The Code Organisation

Operating System - Modules And Events

1 | #define MODULE_DEFINE(VAR, DESC, INIT, DEINIT, ...) | \
2 | Module VAR = { | \
3 | .init = INIT, | \
4 | .deinit = DEINIT, | \
5 | .cnt = 0, | \
6 | .name = DESC, | \
7 | .deps = { __VA_ARGS__ } | \
8 | }
9 | MODULE_DEFINE(CORE, "Central core", init, deinit, &TIME, &COMMAND, &ESP8266);
1 | #define EVENT_REGISTER(eventName, desc)\
2 | Event eventName = \
3 | {.eventId = __COUNTER__, .data = 0, .description = desc, .descLen = sizeof(desc) }
4 | EVENT_REGISTER(EVENT_UART_DELIMITER, "Got UART delimiter");
1 | event_addListener(&EVENT_UART_DELIMITER, callback);
1 | event_fire(&EVENT_UART_DELIMITER, SYSTEM_ADDRESS_CAST (&delimiters[USART_ID][i]));

Realization (1)


Figure 6: Screen Logging

Realization (2)


Figure 7: Appearence Of The Clock

Realization (3)

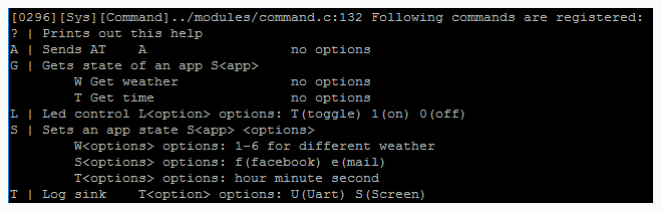
[picture p35: figure]

Figure 8: USART Command Interpreter

## Status Quo and Outlook

What works? What does not? (1)

HW Block | Working | Problem
USB Charging | X
OLED Driver | X
Vcc for C | X
IEEE 802.11 | X
USB2UART | X
LED Driver | | Wrong footprint assignment
Crystal | | Wrong pin assignment
USB DCP | | Further tests necessary

Table 1: Hardware Overview: What works? What does not?

What works? What does not? (2)

SW Block | Working | Problem
UART | X
SPI | X
EPROM | X
Timer | X
ADC
PWM
ESP8266 | X
Terminal | X
SEP525F | X
Wifi
Command | X
Log | X
Screen | X
Timekeeper | X
Controller
Core | X
Weather | X
Clock | X
Social
Table 2: Software Overview: What works? What does not?

Outlook

- HW Rev2 has arrived

Outlook

- HW Rev2 has arrived
- LED driver will work hopefully

Outlook

- HW Rev2 has arrived
- LED driver will work hopefully
- Social connectivity and calendar functions will be implemented

Contact Information

E: | Elmar.Vanrijnswou.9818@student.uu.se
E: | Maximilian.Stiefel.8233@student.uu.se
| https://github.com/s3xm3x/SwakeUp

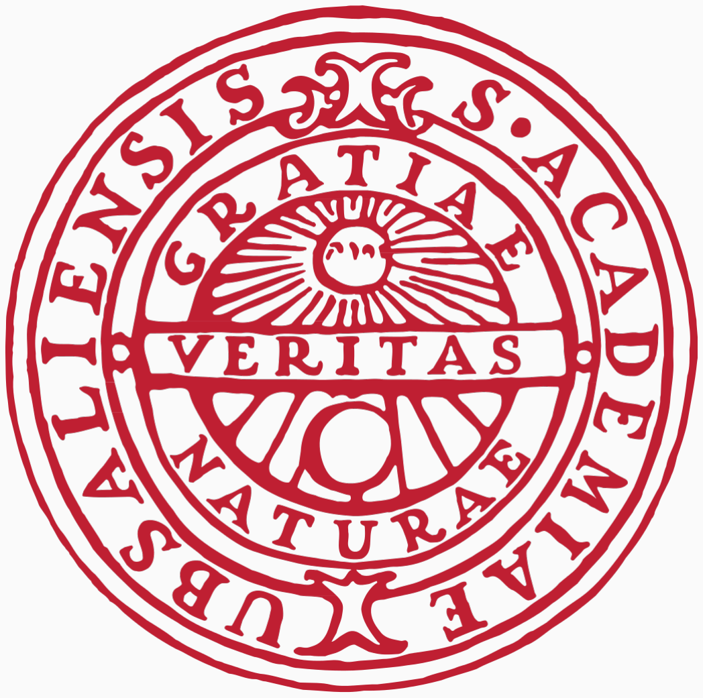
[picture p36: figure]

## Happy Coding :)
