m3x1m0m/SwakeUp/documents/pid/pid_12v_10Hz.png

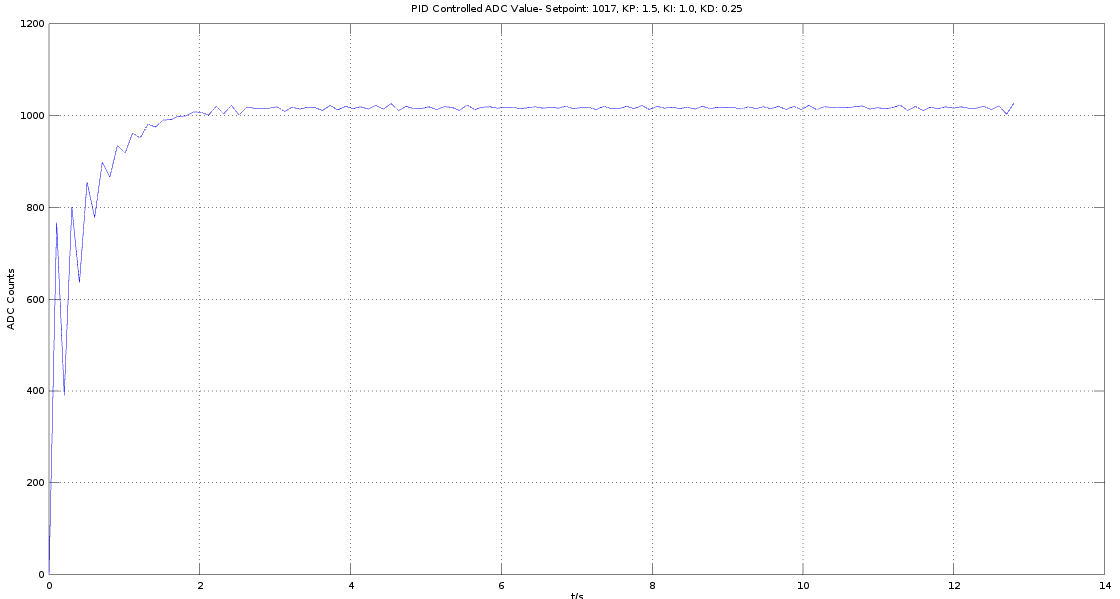
documents/pid/pid_12v_10Hz.png
