m3x1m0m/SwakeUp/simulation/Vgs.jpg

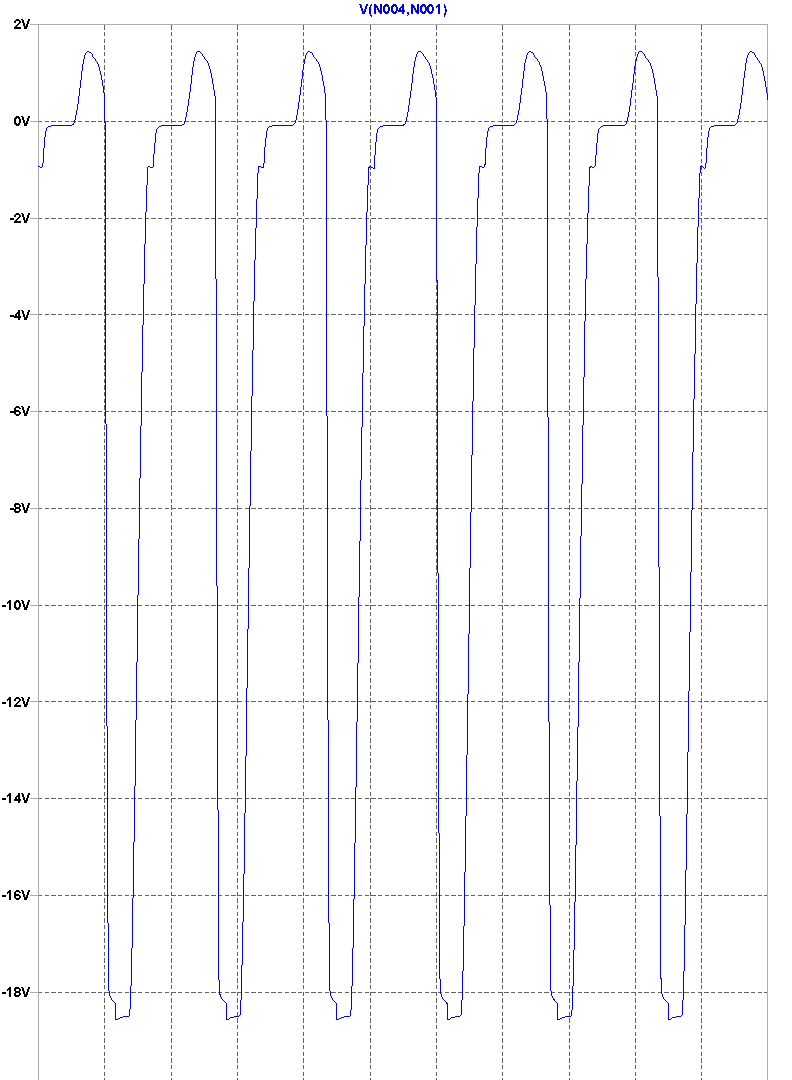
simulation/Vgs.jpg
