m3x1m0m/SwakeUp/pcb/logic/Rev2/Bom_SwakeUpp.xlsx

B1 | Tactile_Button_2term | TACTILE_MINATUE_SMD_3.5x6mm | 1 | 0.22 | 1 | 450-1140-ND
C1, C2, C3, C11 | 12pF | C0402 | 4 | 0.035 | 10 | 399-1013-1-ND | 0.35
C4, C5, C6, C8, C9 | 100nF | C0603 | 5 | 0.093 | 10 | 490-3298-1-ND | 0.93
C10 | 1uF | C0603 | 1 | 0.033 | 10 | 311-1372-1-ND | 0.33
FB1 | 50R @ 20MHz | L0805 | 1 | 0.11 | 1 | 490-1054-1-ND | 0.11
H1 | Header_PDI | 6-HEADER_BOXED | 1 | 0.52 | 1 | 609-5122-ND | 0.52
H2 | USB_5pin | USB_Micro_B_RECEPTABLE_FCI | 1 | 0.46 |  | 609-4616-1-ND | 0
H3, H4 | Header_4 | Header_MALE_4 | 2 |  |  |  | 0
H5, H6 | Header_2 | Header_MALE_2 | 2 |  |  |  | 0
H8, H9 | Header_3 | Header_MALE_3 | 2 | 0.41 | 1 | S1012EC-24-ND | 0.41
IC* | ESP12-E | ESP12-E | 1 | 3 | 1 |  | 3
IC1 | ATXMEGA128A4U-MH | 44-VFQFN-E | 1 | 6.4 | 1 | ATXMEGA128A4U-MHRCT-ND | 6.4
IC3 | CP_2102 | 28-QFN_Exposed_pad | 1 | 2.88 | 1 | 336-1160-1-ND | 2.88
LED1, LED2 | LED | 0603_LED | 2 | 0.27 | 2 | 160-1445-1-ND | 0.54
m1 | OEL Display Module | FFC-35-pin-0.5 | 1 | 0.98 | 1 | A101317CT-ND | 0.98
R1, R2, R4, R5, R6, R7, R8, R11, R12 | 10k | R0603 | 9 | 0.008 | 25 | 311-10KGRCT-ND | 0.2
R3 | 70K | R0603 | 1 | 0.014 | 10 | 311-71.5KHRCT-ND | 0.14
R9, R10 | 1k | R0603 | 2 | 0.011 | 10 | 311-1.0KGRCT-ND | 0.11
Y1 | 32.768 | crystal_6.2x2.1x2.1 | 1 | 0.21 | 1 | 535-9032-ND | 0.21
Y2 | Crystal_Ground | Crystal_3.2x2.5 | 1 | 0.54 | 1 | SER4070CT-ND | 0.54
 |  |  |  |  |  |  | 17.65
