m3x1m0m/SwakeUp/pcb/power/power.step

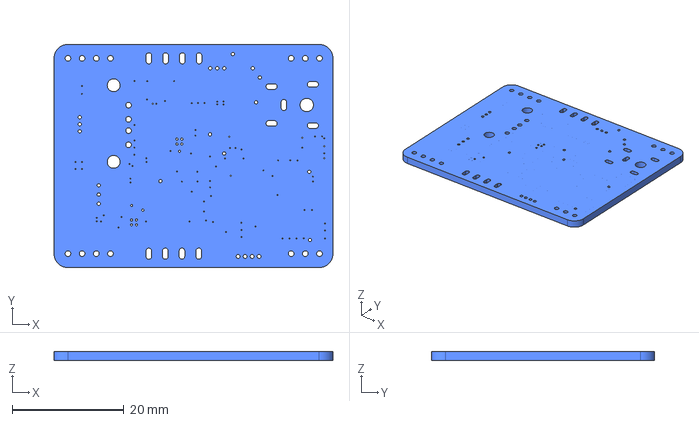
[picture p39: CAD file, 2017-01-26]
pcb/power/power.step
50.0 x 40.0 x 1.60 mm
