m3x1m0m/SwakeUp/(list of files, cad)

Other CAD files:
pcb/power/power.FCStd
