m3x1m0m/SwakeUp/simulation/simulation_results_with_feedback.png

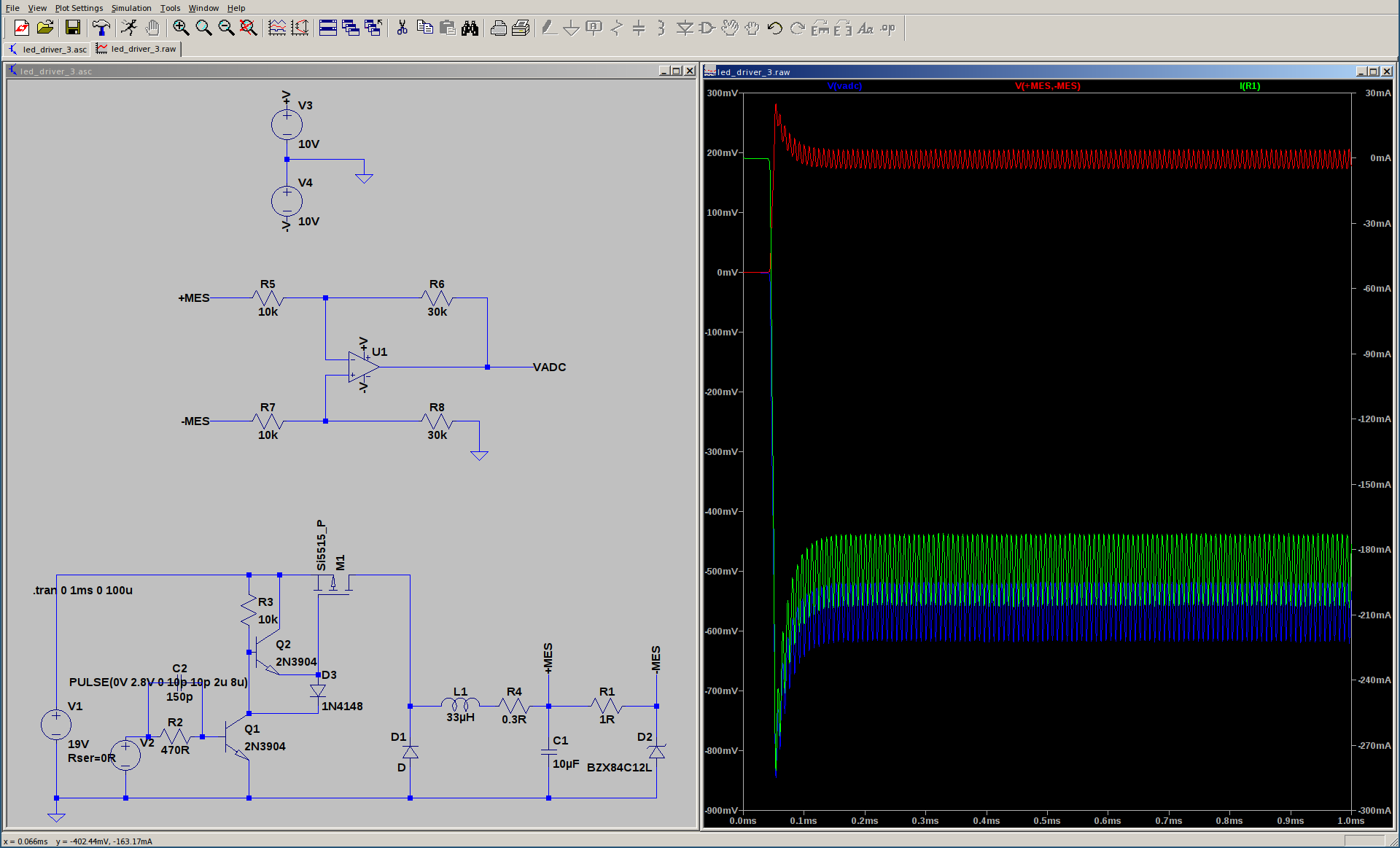
simulation/simulation_results_with_feedback.png
