m3x1m0m/SwakeUp/(threads)

Thread 2 (2017-05-18):

ADC 1 to ADC 4 Caption

m3x1m0m, 2017-05-18:
On the logic board the caption is reversed. PLS make ADC1, such as this is the feedback for the red color channel.

Thread 3 (2017-05-18):

Initialization of Modules with Dependencies

m3x1m0m, 2017-05-18:
For instance is it not possible (i.e. it is implemented but does not work) to initialize the PID module, which needs the PWM and ADC module by just saying, that these dependencies are given.

Thread 8 (2017-05-25):

Event system is way too slow.

m3x1m0m, 2017-05-25:
System crashes when too many events are posted at a time. A 10 ms tick is not possible with 32 MHz system clock while the screen driver is operated.

elamre, 2017-05-26:
Screen got optimized, XMEGA not fast enough for 10 ms ticks due to interrupt overhead

Closed 2017-05-26.
