m3x1m0m/SwakeUp/pcb/logic/Rev2/SwakeUpp.pdf

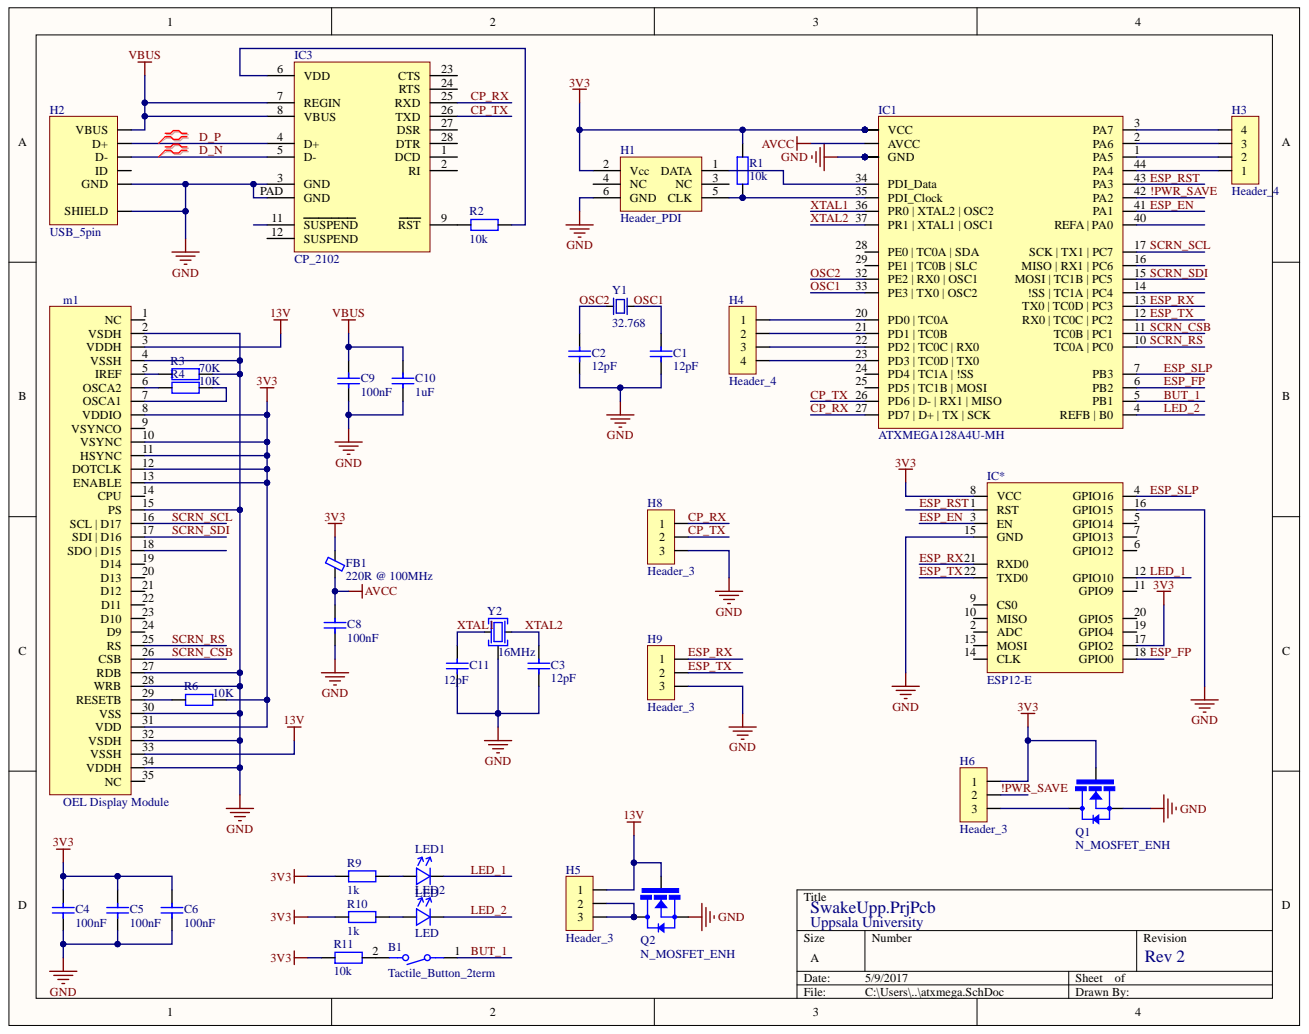
[picture p46: page 1]

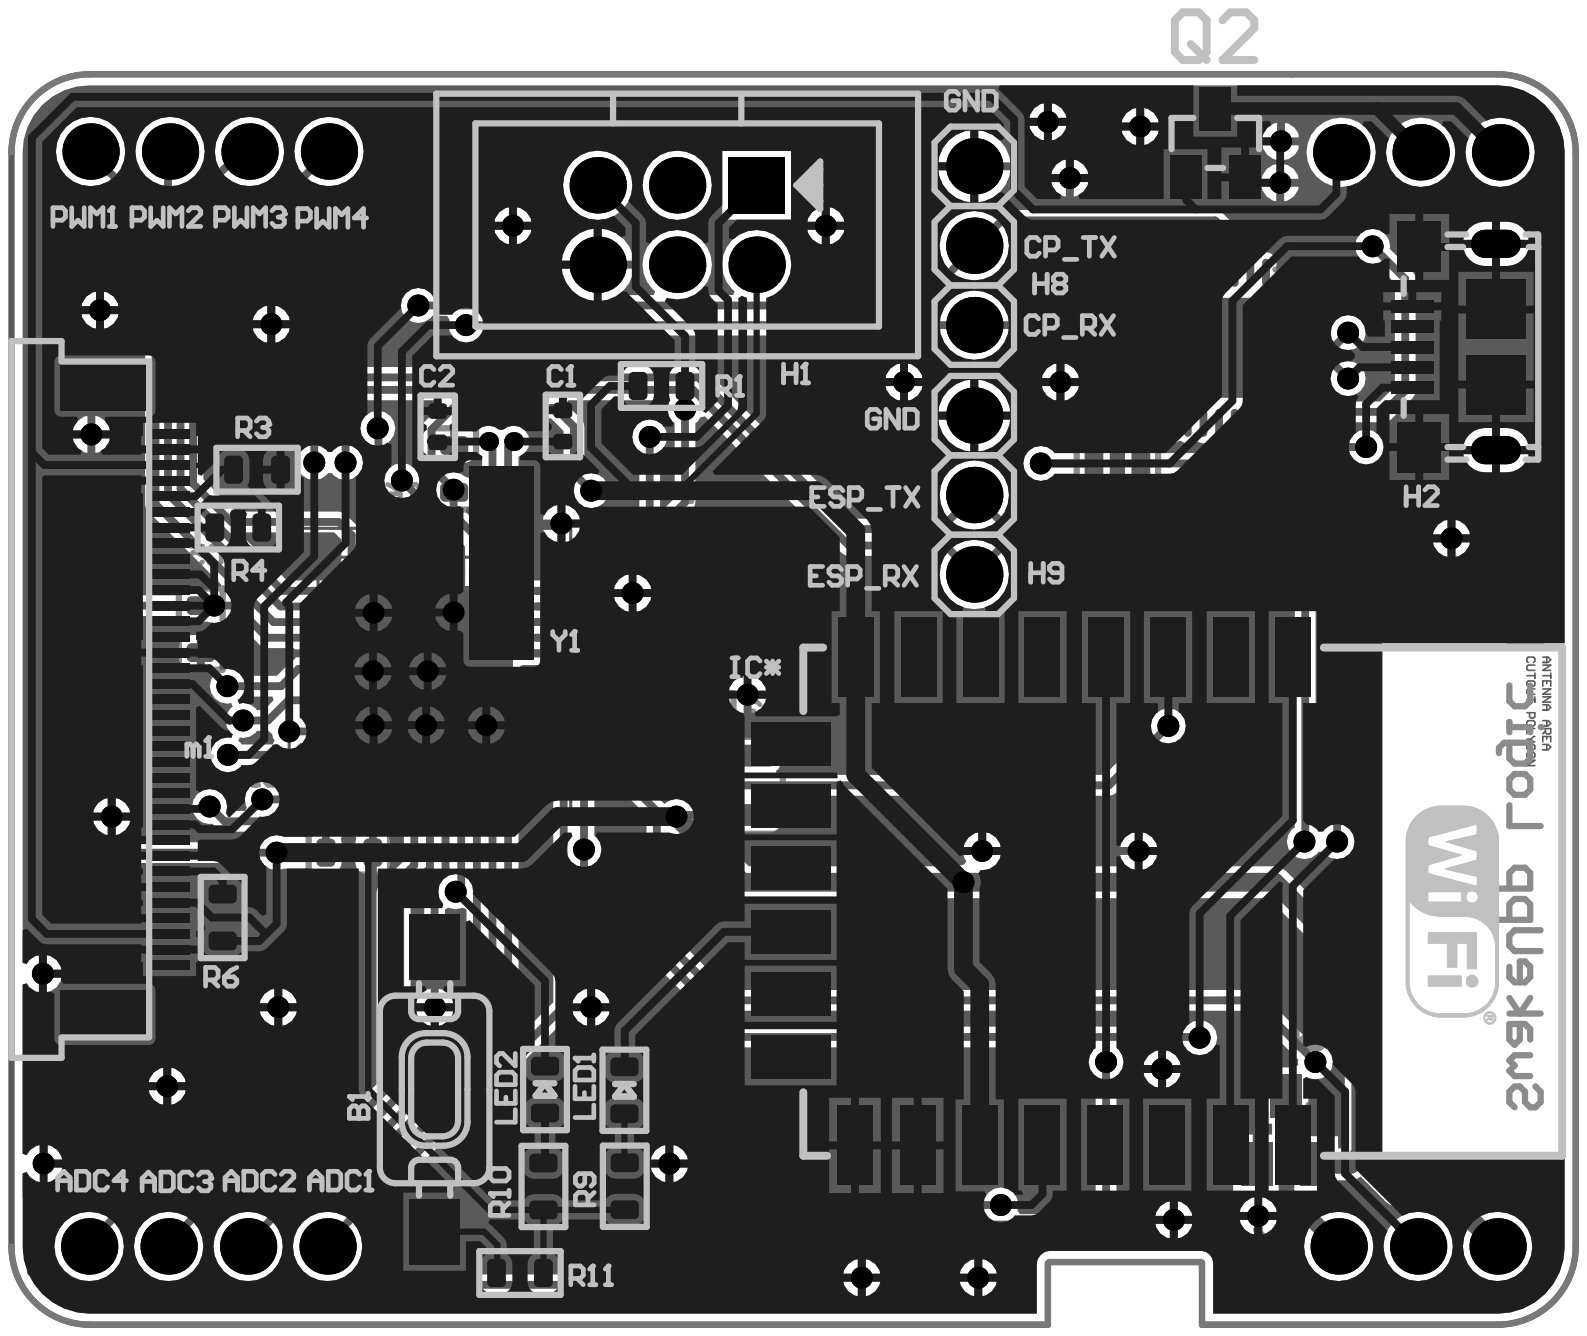
[picture p47: page 2]
