m3x1m0m/SwakeUp/pcb/logic/Rev1/atxmega.pdf

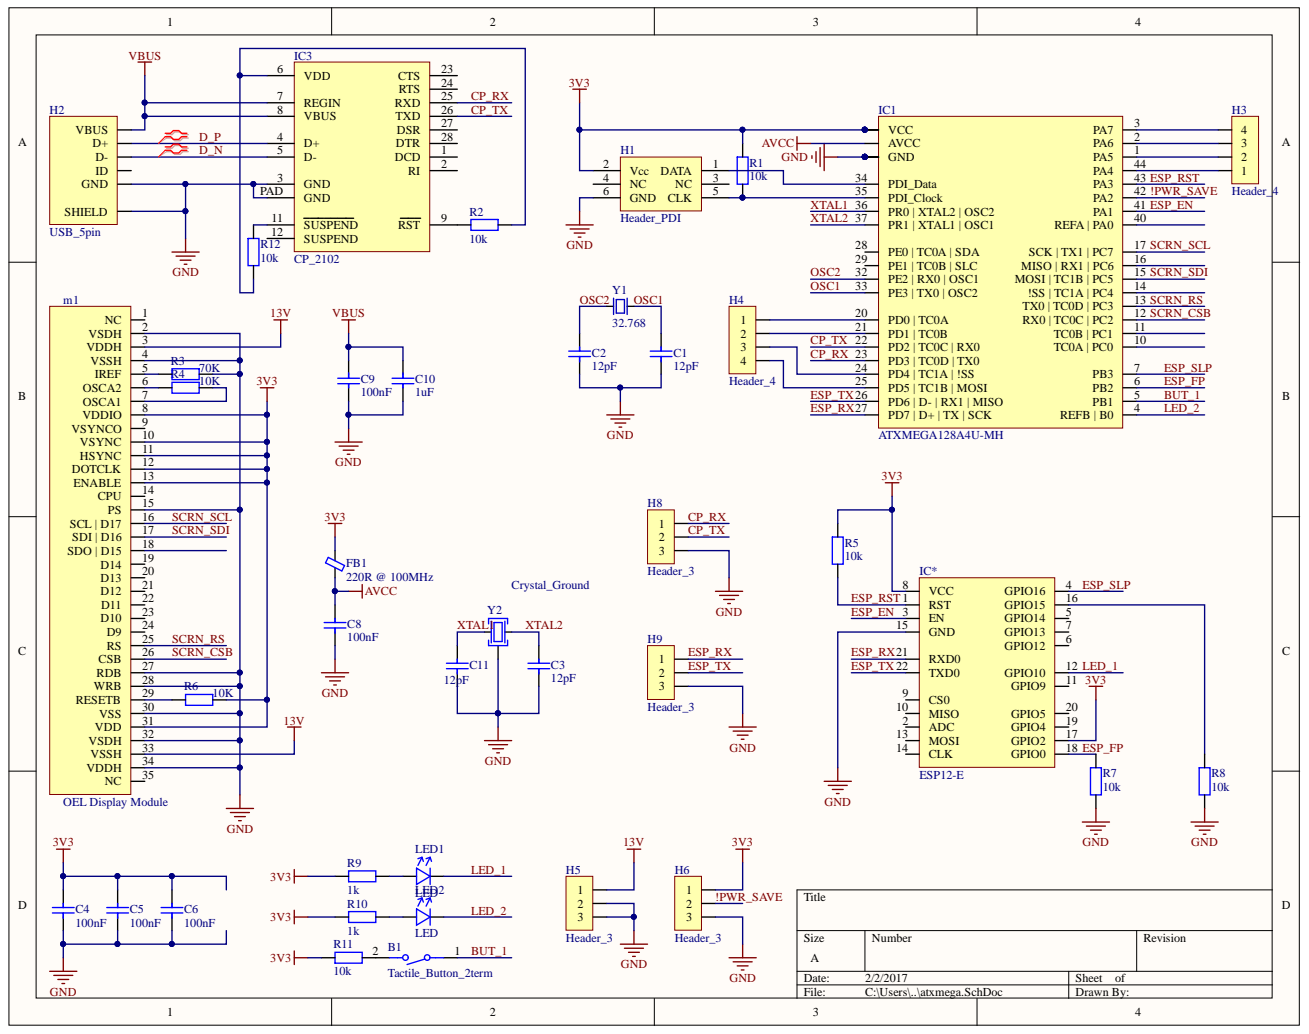
[picture p48: page 1]
