m3x1m0m/SwakeUp/simulation/led_driver_3.asc

C1: cap; 22µF
C2: cap; 150p
C3: cap; 22nF
D1: diode
D2: zener; BZX84C12L
D3: diode; 1N4148
L1: ind; 33µH
M1: pmos; Si5515_P
Q1: npn; 2N3904
Q2: npn; 2N3904
R1: res; 1R
R2: res; 470R
R3: res; 10k
R4: res; 0.3R
R5: res; 20k
R6: res; 120k
R7: res; 20k
R8: res; 120k
R9: res; 47k
U2: opamp2; LM324
V1: voltage; 19V; Rser=0R
V2: voltage; PULSE(0V 2.8V 0 10p 10p 1u 4u)
V3: voltage; 10V
V4: voltage; 10V
Named nets: 0, VADC, +MES, -MES, +V, -V
.tran 0 10ms 1ms 1ms
.lib LM324.ti.lib
