m3x1m0m/SwakeUp/simulation/low_pass_amp.asc

C1: cap; 47n
C2: cap; 47n
R1: res; 10k
R2: res; 10k
R4: res; 120k
R5: res; 30k
U1: UniversalOpamp2
V1: voltage; 19V
V2: voltage; 19V
V3: voltage; PULSE(0 3.3V 0 10n 10n 14u 16u)
Named nets: 0, V+, V-, VOUT
.tran 0 30ms 0ms 1us
