m3x1m0m/SwakeUp/simulation/differential_amp.asc

C1: cap; 22n
I1: current; 300mA
R1: res; 10k
R2: res; 30k
R3: res; 10k
R4: res; 30k
R5: res; 1R
R6: res; 4.7k
U1: UniversalOpamp2
V1: voltage; 10
V2: voltage; 10
Named nets: 0, OUT, V+, V-
.tran 0 10ms 0ms 1ms
