m3x1m0m/SwakeUp/simulation/led_driver_2.asc

C1: cap; 10µF
C2: cap; 150p
D1: diode
D2: zener; BZX84C12L
D3: diode; 1N4148
L1: ind; 33µH
M1: pmos; Si5515_P
Q1: npn; 2N3904
Q2: npn; 2N3904
R1: res; 0.1R
R2: res; 470R
R3: res; 10k
R4: res; 1R
V1: voltage; 19V; Rser=0R
V2: voltage; PULSE(0V 2.8V 0 10p 10p 0.1u 1u)
Named nets: 0
.tran 0 1ms 0 100u
