m3x1m0m/SwakeUp/documents/simulation/pwm_list.asc

C1: cap; 10n
C2: cap; 10n
C3: cap; 10n
C4: cap; 10n
R1: res; 47k
R2: res; 47k
R3: res; 47k
R4: res; 47k
V1: voltage; PULSE(0 2.8 0 {1e-6/FREQ} {1e-6/FREQ} {PWM*1/FREQ} {1/FREQ})
Named nets: 0, out_single, out_tripple, pwm_in
.step param PWM list 0.001, 0.2, 0.4, 0.6 0.8, 0.999
.param FREQ = 30000
.tran 100m
