m3x1m0m/SwakeUp/documents/simulation/sim_bucket_2.asc

C1: cap; 10µF
C2: cap; 150p
D1: schottky
D2: zener; BZX84C12L
D3: diode; 1N4148
L1: ind; 300µH
M1: pmos; Si5515_P
Q1: npn; 2N3904
Q2: npn; 2N3904
R1: res; 0.1R
R2: res; 470R
R3: res; 10k
R4: res; 1R
V1: voltage; 20V; Rser=0R
V2: voltage; PULSE(0 5 0 1p 1p 0.3u 2u)
Named nets: 0
.tran 0 5ms 0 1u
