m3x1m0m/SwakeUp/documents/simulation/sim_bucket_1.asc

C1: cap; 100µF
D1: schottky
D2: LED
L1: ind; 100mH
M1: nmos; BSC077N12NS3
R1: res; 0.1R
R2: res; 1R
R3: res; 10K
V1: voltage; 20V; Rser=0R
V2: voltage; PULSE(-15 15 0 1u 1u 500u 1ms)
Named nets: 0
.tran 0 50ms 0 1u
