m3x1m0m/SwakeUp/(list of files, drawings)

Other design files:
pcb/logic/Rev1/atxmega.PcbDoc
pcb/logic/Rev1/atxmega.SchDoc
pcb/logic/Rev1/SwakeUpp.PrjPcb
pcb/logic/Rev2/atxmega.PcbDoc
pcb/logic/Rev2/atxmega.SchDoc
pcb/logic/Rev2/SwakeUpp.PrjPcb
pcb/logic/SwakeUpp.PrjPcb
