m3x1m0m/SwakeUp/pcb/power/power.kicad_pcb

## KiCad design pcb/power/power.kicad_pcb (2017-02-18)

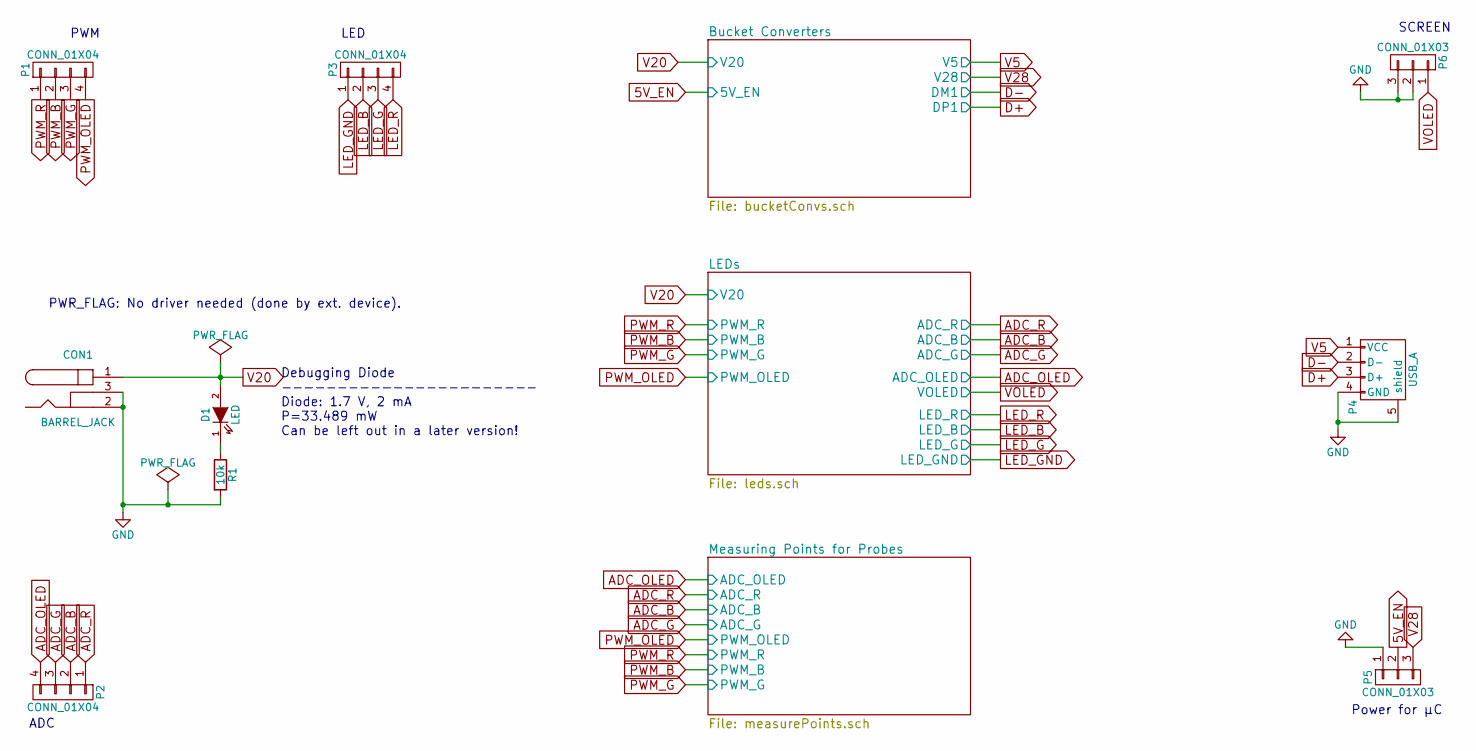
[picture p49: schematic power.sch, Power Board]

Parts:
CON1: BARREL_JACK; PJ-047BH_BARREL_JACK; Digikey CP-047BH-ND
D1: LED; LED_0603; Digikey 475-3118-1-ND
P1, P2: CONN_01X04; ESQ-104-12-G-S-LL
P3: CONN_01X04; LED_CONN_1.25_PITCH
P4: USB_A; Digikey 609-1045-ND
P5, P6: CONN_01X03; ESQ-103-12-G-S-LL
R1: 10k; R_0603_HandSoldering_Same_As_C; Digikey 311-10KGRCT-ND

Connections:
5V_EN: P5.2; also elsewhere on the board
ADC_B: P2.2; also elsewhere on the board
ADC_G: P2.3; also elsewhere on the board
ADC_OLED: P2.4; also elsewhere on the board
ADC_R: P2.1; also elsewhere on the board
D+: P4.3 (D+); also elsewhere on the board
D-: P4.2 (D-); also elsewhere on the board
LED_B: P3.2; also elsewhere on the board
LED_G: P3.3; also elsewhere on the board
LED_GND: CON1.2, CON1.3, P3.1, P4.4 (GND), P4.5 (shield), P5.1, P6.2, P6.3, R1.2; also elsewhere on the board
LED_R: P3.4; also elsewhere on the board
unnamed: D1.1 (K), R1.1
PWM_B: P1.2; also elsewhere on the board
PWM_G: P1.3; also elsewhere on the board
PWM_OLED: P1.4; also elsewhere on the board
PWM_R: P1.1; also elsewhere on the board
V5: P4.1 (VCC); also elsewhere on the board
V20: CON1.1, D1.2 (A); also elsewhere on the board
V28: P5.3; also elsewhere on the board
VOLED: P6.1; also elsewhere on the board

Notes on the sheet:
ADC
PWM
SCREEN
Debugging Diode ----------------------- Diode: 1.7 V, 2 mA P=33.489 mW Can be left out in a later version!
PWR_FLAG: No driver needed (done by ext. device).
Power for µC
LED

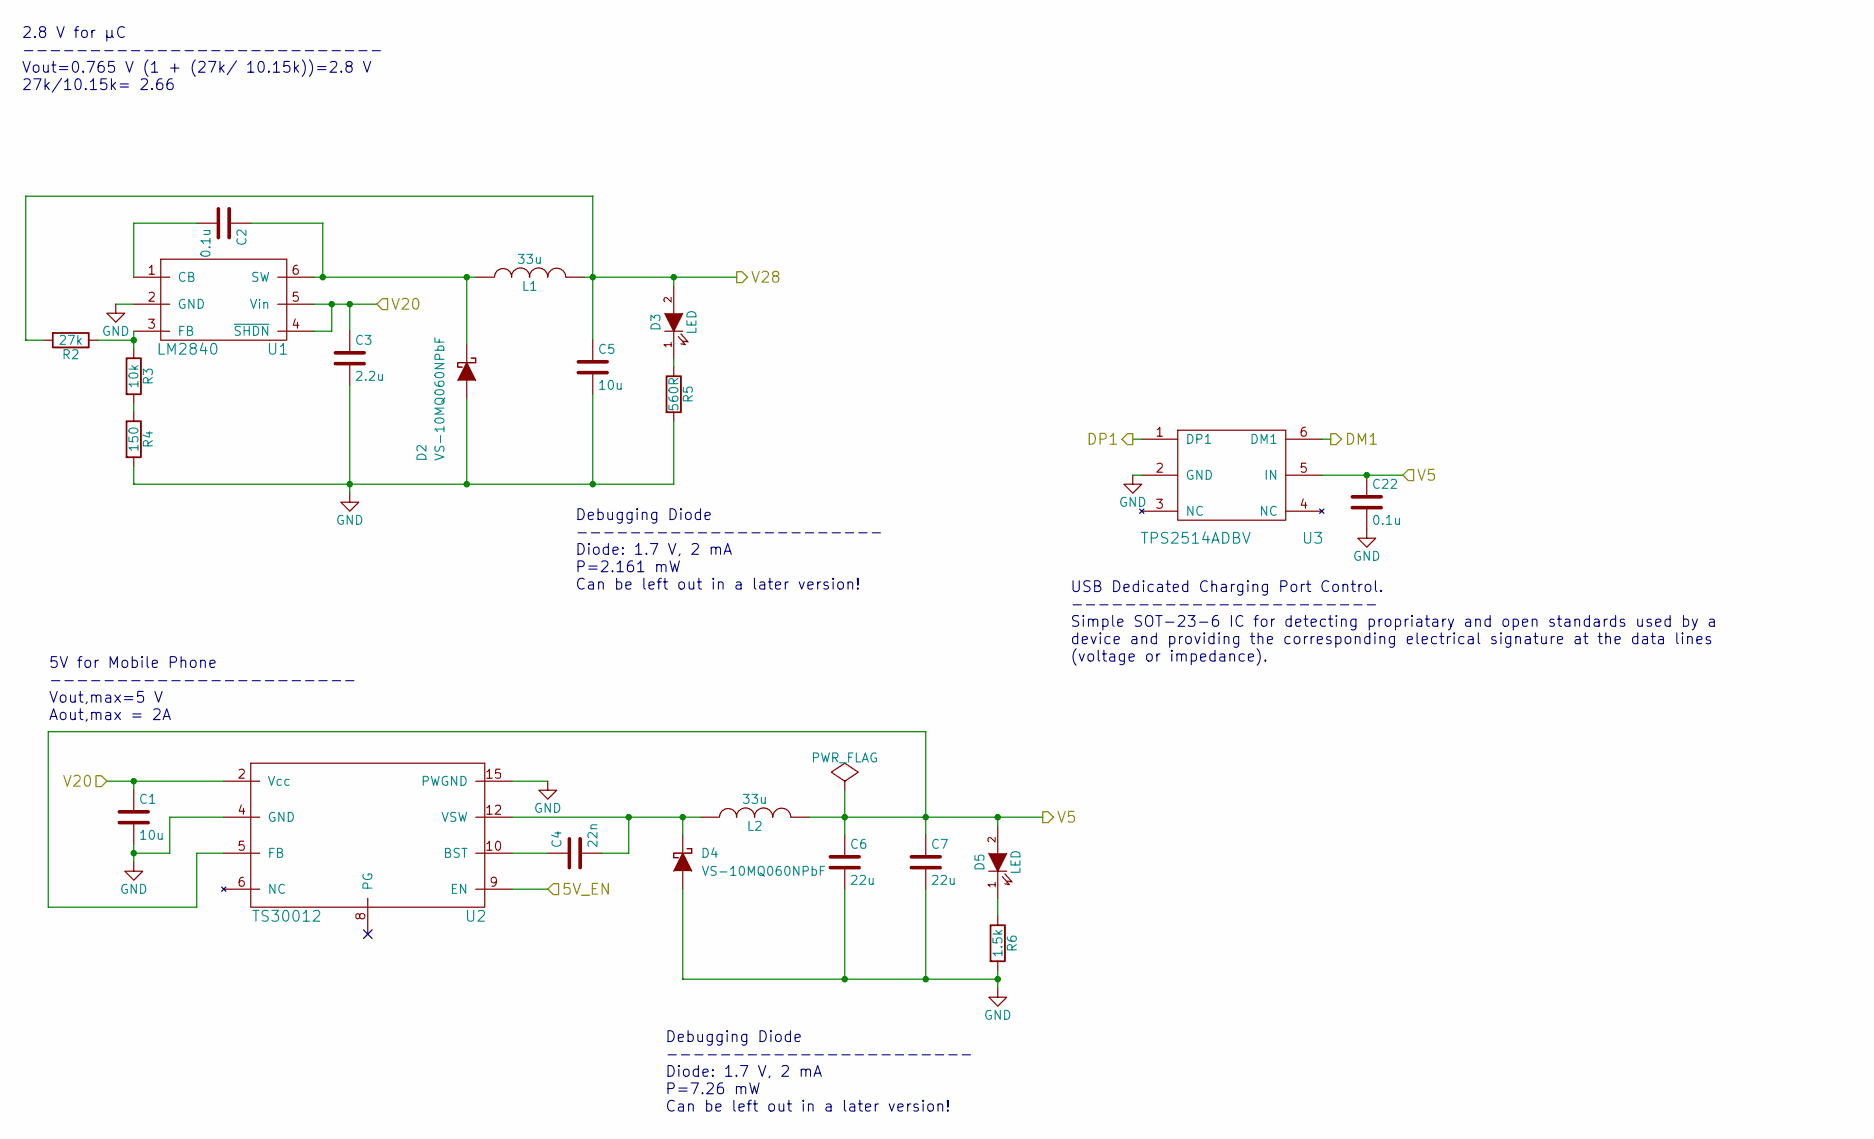
[picture p50: schematic bucketConvs.sch, Bucket Converters for 5 V and 2.8 V]

Parts:
C1, C5: 10u; C_0603_HandSoldering; Digikey 490-12323-1-ND
C2, C22: 0.1u; C_0603_HandSoldering; Digikey 311-1343-1-ND
C3: 2.2u; C_0603_HandSoldering; Digikey 490-7204-1-ND
C4: 22n; C_0603_HandSoldering; Digikey 445-8118-1-ND
C6, C7: 22u; C_0603_HandSoldering; Digikey 1276-1193-1-ND
D2, D4: VS-10MQ060NPbF; SMA_Handsoldering; Digikey 10MQ060NPBFCT-ND
D3, D5: LED; LED_0603; Digikey 475-3118-1-ND
L1, L2: 33u; Bourns_SRN3015; Digikey SRN3015-330MCT-ND
R2: 27k; R_0603_HandSoldering_Same_As_C; Digikey P27.0KHCT-ND
R3: 10k; R_0603_HandSoldering_Same_As_C; Digikey 311-10KGRCT-ND
R4: 150; R_0603_HandSoldering_Same_As_C; Digikey 311-150HRCT-ND
R5: 560R; R_0603_HandSoldering_Same_As_C; Digikey 311-560GRCT-ND
R6: 1.5k; R_0603_HandSoldering_Same_As_C; Digikey 311-1.5KGRCT-ND
U1: LM2840; SOT-23-6; Digikey LM2840XMK-ADJL/NOPBCT-ND
U2: TS30012; QFN-16-1EP_3x3mm_Pitch0.5mm; Digikey TS30012-M050QFNRCT-ND
U3: TPS2514ADBV; SOT-23-6; Digikey 296-40725-1-ND

Connections:
5V_EN: U2.9 (EN); also elsewhere on the board
D+: U3.1 (DP1); also elsewhere on the board
D-: U3.6 (DM1); also elsewhere on the board
LED_GND: C1.2, C3.2, C5.2, C6.2, C7.2, C22.2, D2.2 (A), D4.2 (A), R4.2, R5.2, R6.2, U1.2 (GND), U2.4 (GND), U2.14 (PWGND), U2.15 (PWGND), U3.2 (GND); also elsewhere on the board
unnamed: C2.1, D2.1 (K), L1.1, U1.6 (SW)
unnamed: C2.2, U1.1 (CB)
unnamed: C4.1, U2.10 (BST)
unnamed: C4.2, D4.1 (K), L2.1, U2.1 (VSW), U2.12 (VSW), U2.13 (VSW), U2.16 (VSW)
unnamed: D3.1 (K), R5.1
unnamed: D5.1 (K), R6.1
unnamed: R2.1, R3.1, U1.3 (FB)
unnamed: R3.2, R4.1
V5: C6.1, C7.1, C22.1, D5.2 (A), L2.2, U2.5 (FB), U3.5 (IN); also elsewhere on the board
V20: C1.1, C3.1, U1.4 (~SHDN), U1.5 (Vin), U2.2 (Vcc), U2.3 (Vcc), U2.11 (Vcc); also elsewhere on the board
V28: C5.1, D3.2 (A), L1.2, R2.2; also elsewhere on the board

Notes on the sheet:
2.8 V for µC --------------------------- Vout=0.765 V (1 + (27k/ 10.15k))=2.8 V 27k/10.15k= 2.66
Debugging Diode ----------------------- Diode: 1.7 V, 2 mA P=2.161 mW Can be left out in a later version!
Debugging Diode ----------------------- Diode: 1.7 V, 2 mA P=7.26 mW Can be left out in a later version!
5V for Mobile Phone ----------------------- Vout,max=5 V Aout,max = 2A
USB Dedicated Charging Port Control. ----------------------- Simple SOT-23-6 IC for detecting propriatary and open standards used by a device and providing the corresponding electrical signature at the data lines (voltage or impedance).

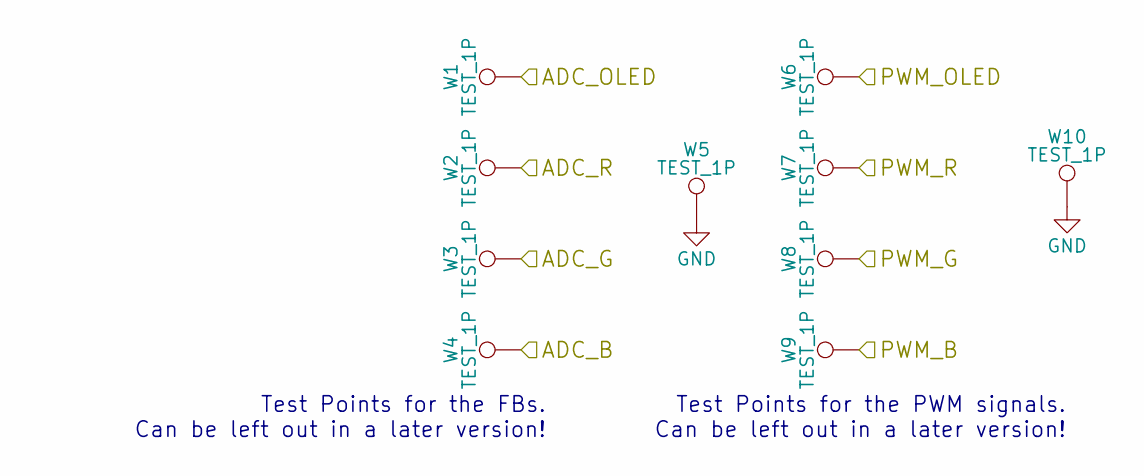
[picture p51: schematic measurePoints.sch, Test Points]

Parts:
W1, W2, W3, W4, W6, W7, W8, W9: TEST_1P; TP_PROBE
W5, W10: TEST_1P; GND_PROBE

Connections:
ADC_B: W4.1; also elsewhere on the board
ADC_G: W3.1; also elsewhere on the board
ADC_OLED: W1.1; also elsewhere on the board
ADC_R: W2.1; also elsewhere on the board
LED_GND: W5.1, W10.1; also elsewhere on the board
PWM_B: W9.1; also elsewhere on the board
PWM_G: W8.1; also elsewhere on the board
PWM_OLED: W6.1; also elsewhere on the board
PWM_R: W7.1; also elsewhere on the board

Notes on the sheet:
Test Points for the FBs. Can be left out in a later version!
Test Points for the PWM signals. Can be left out in a later version!

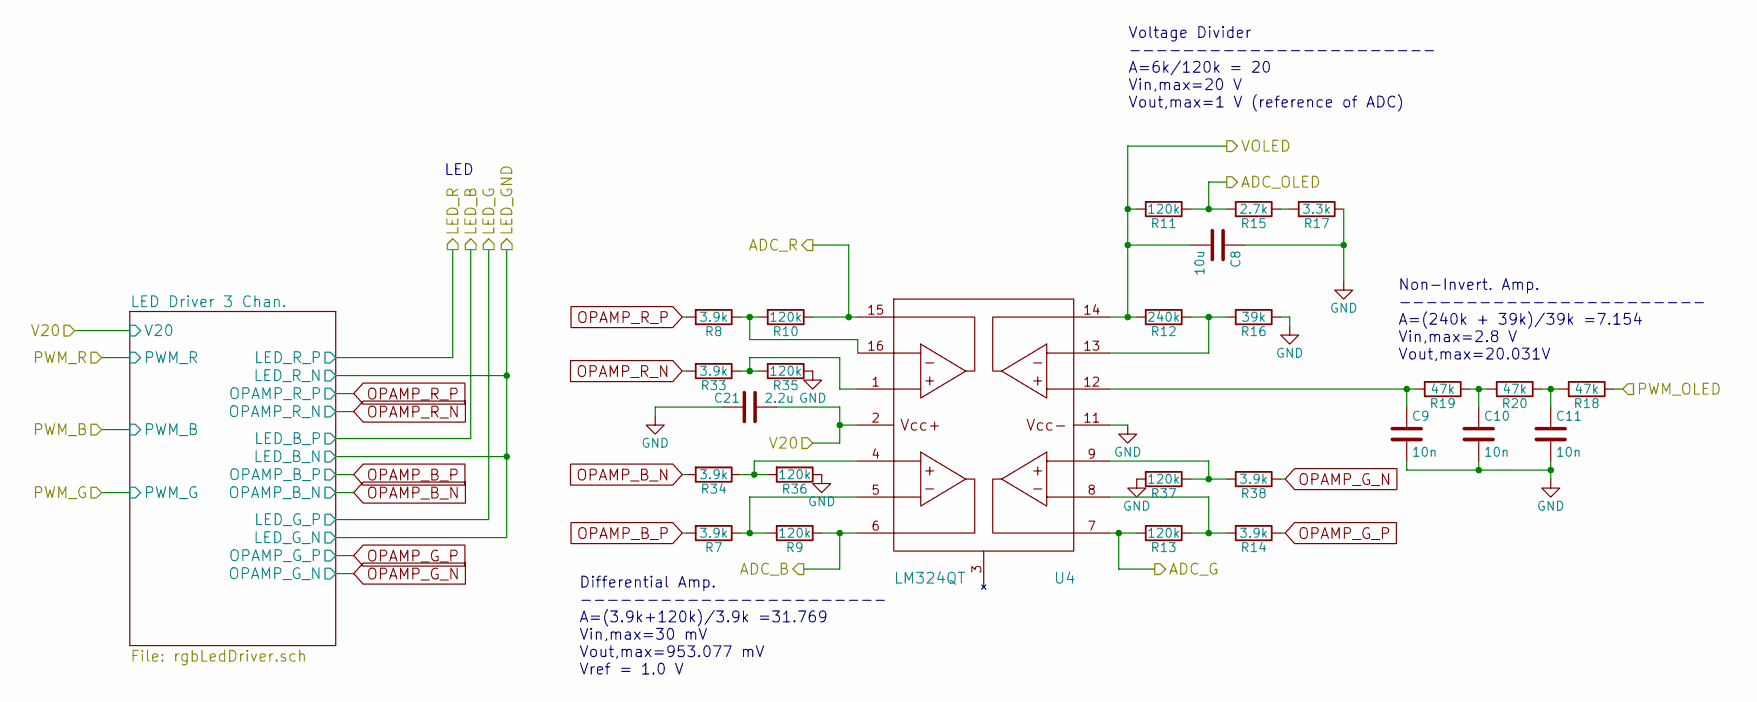
[picture p52: schematic leds.sch, LEDs]

Parts:
C8: 10u; C_0603_HandSoldering; Digikey 490-12323-1-ND
C9, C10, C11: 10n; C_0603_HandSoldering; Digikey 311-1085-1-ND
C21: 2.2u; C_0603_HandSoldering; Digikey 490-7204-1-ND
R7, R8, R14, R33, R34, R38: 3.9k; R_0603_HandSoldering_Same_As_C; Digikey 311-3.90KHRCT-ND
R9, R10, R11, R13, R35, R36, R37: 120k; R_0603_HandSoldering_Same_As_C; Digikey 311-120KHRCT-ND
R12: 240k; R_0603_HandSoldering_Same_As_C; Digikey 311-240KHRCT-ND
R15: 2.7k; R_0603_HandSoldering_Same_As_C; Digikey 311-2.70KHRCT-ND
R16: 39k; R_0603_HandSoldering_Same_As_C; Digikey 311-39.0KHRCT-ND
R17: 3.3k; R_0603_HandSoldering_Same_As_C; Digikey 311-3.30KHRCT-ND
R18, R19, R20: 47k; R_0603_HandSoldering_Same_As_C; Digikey 311-47.0KHRCT-ND
U4: LM324QT; QFN-16-1EP_3x3mm_Pitch0.5mm; Digikey 497-12005-1-ND

Connections:
ADC_B: R9.1, U4.6 (O_2); also elsewhere on the board
ADC_G: R13.2, U4.7 (O_3); also elsewhere on the board
ADC_OLED: R11.1, R15.2; also elsewhere on the board
ADC_R: R10.1, U4.15 (O_1); also elsewhere on the board
LED_B: R34.2; also elsewhere on the board
LED_G: R38.1; also elsewhere on the board
LED_GND: C8.1, C9.2, C10.2, C11.2, C21.1, R16.1, R17.1, R35.1, R36.1, R37.2, U4.11 (Vcc-); also elsewhere on the board
LED_R: R33.2; also elsewhere on the board
unnamed: C9.1, R19.2, U4.12 (P_4)
unnamed: C10.1, R19.1, R20.2
unnamed: C11.1, R18.2, R20.1
unnamed: R7.1, R9.2, U4.5 (N_2)
unnamed: R8.1, R10.2, U4.16 (N_1)
unnamed: R12.1, R16.2, U4.13 (N_4)
unnamed: R13.1, R14.2, U4.8 (N_3)
unnamed: R15.1, R17.2
unnamed: R33.1, R35.2, U4.1 (P_1)
unnamed: R34.1, R36.2, U4.4 (P_2)
unnamed: R37.1, R38.2, U4.9 (P_3)
OPAMP_B_P: R7.2; also elsewhere on the board
OPAMP_G_P: R14.1; also elsewhere on the board
OPAMP_R_P: R8.2; also elsewhere on the board
PWM_OLED: R18.1; also elsewhere on the board
V20: C21.2, U4.2 (Vcc+); also elsewhere on the board
VOLED: C8.2, R11.2, R12.2, U4.14 (O_4); also elsewhere on the board

Notes on the sheet:
Non-Invert. Amp. ----------------------- A=(240k + 39k)/39k =7.154 Vin,max=2.8 V Vout,max=20.031V
Differential Amp. ----------------------- A=(3.9k+120k)/3.9k =31.769 Vin,max=30 mV Vout,max=953.077 mV Vref = 1.0 V
Voltage Divider ----------------------- A=6k/120k = 20 Vin,max=20 V Vout,max=1 V (reference of ADC)
LED

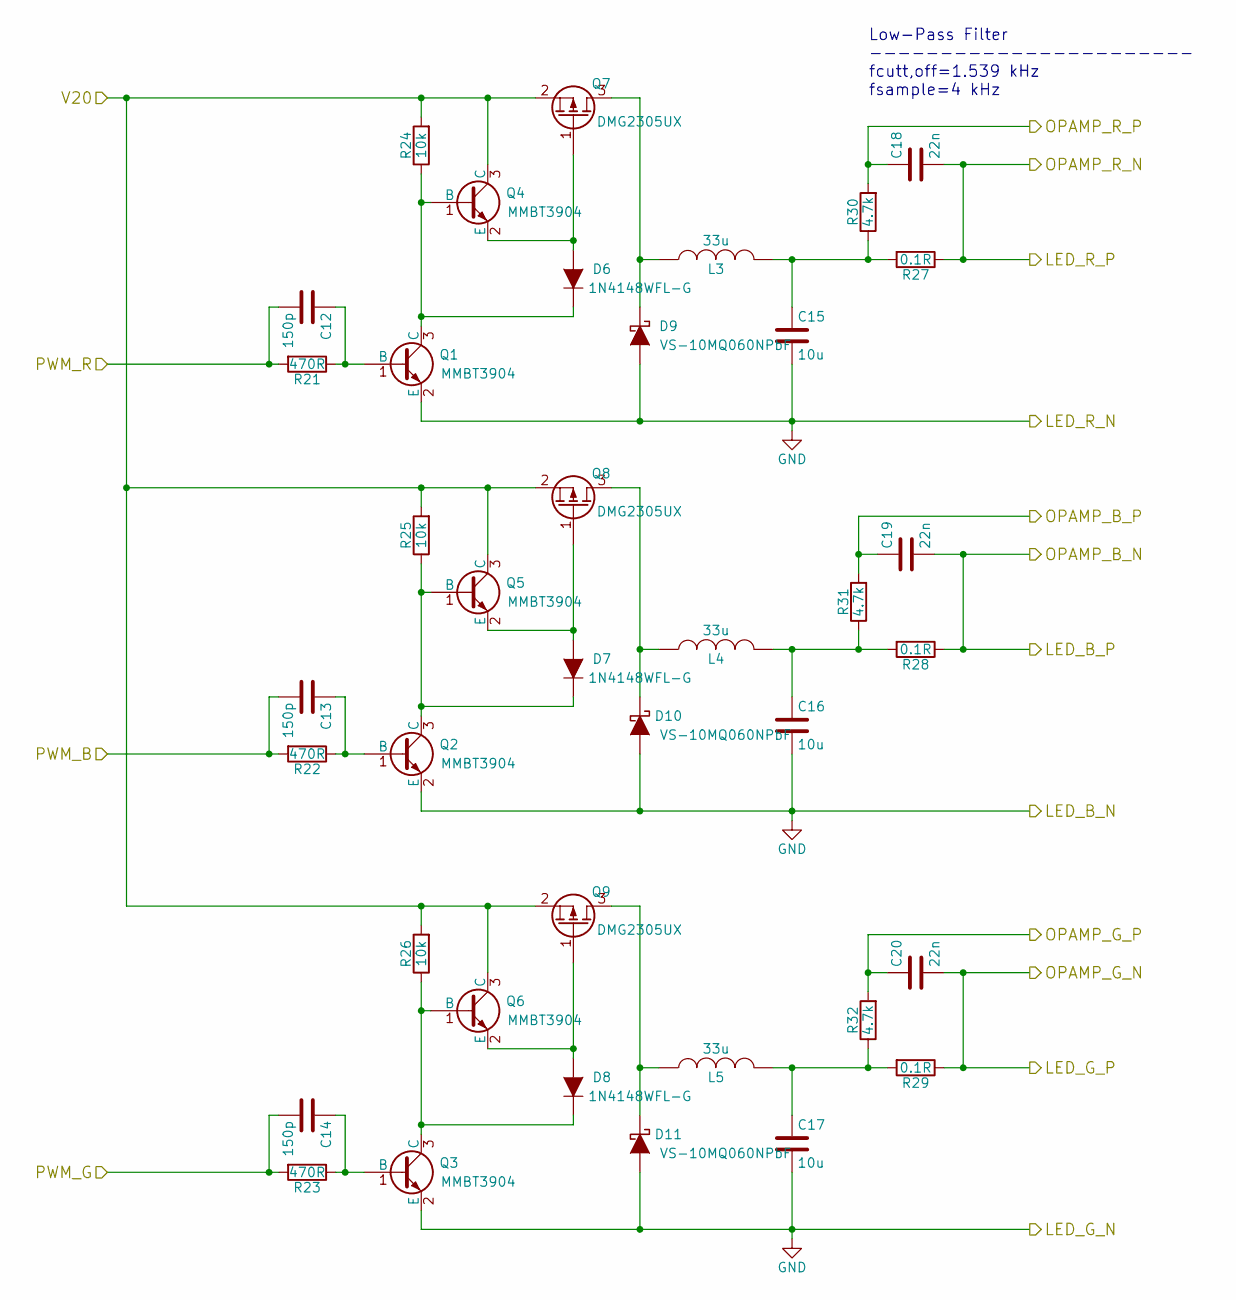
[picture p53: schematic rgbLedDriver.sch, RGB LED Driver]

Parts:
C12, C13, C14: 150p; C_0603_HandSoldering; Digikey 399-1063-1-ND
C15, C16, C17: 10u; C_0603_HandSoldering; Digikey 490-12323-1-ND
C18, C19, C20: 22n; C_0603_HandSoldering; Digikey 1276-1104-1-ND
D6, D7, D8: 1N4148WFL-G; SOD-123F; Farnell 1621821
D9, D10, D11: VS-10MQ060NPbF; SMA_Handsoldering; Digikey 10MQ060NPBFCT-ND
L3, L4, L5: 33u; Bourns_SRN3015; Digikey SRN3015-330MCT-ND
Q1, Q2, Q3, Q4, Q5, Q6: MMBT3904; SOT-23; Digikey MMBT3904TPMSCT-ND
Q7, Q8, Q9: DMG2305UX; SOT-23
R21, R22, R23: 470R; R_0603_HandSoldering_Same_As_C; Digikey 311-470HRCT-ND
R24, R25, R26: 10k; R_0603_HandSoldering_Same_As_C; Digikey 311-10KGRCT-ND
R27, R28, R29: 0.1R; R_0603_HandSoldering_Same_As_C; Digikey 1276-6155-1-ND
R30, R31, R32: 4.7k; R_0603_HandSoldering_Same_As_C; Digikey 311-4.7KGRCT-ND

Connections:
LED_B: C19.2, R28.1; also elsewhere on the board
LED_G: C20.2, R29.1; also elsewhere on the board
LED_GND: C15.2, C16.2, C17.2, D9.2 (A), D10.2 (A), D11.2 (A), Q1.2 (E), Q2.2 (E), Q3.2 (E); also elsewhere on the board
LED_R: C18.2, R27.1; also elsewhere on the board
unnamed: C12.1, Q1.1 (B), R21.1
unnamed: C13.1, Q2.1 (B), R22.1
unnamed: C14.1, Q3.1 (B), R23.1
unnamed: C15.1, L3.2, R27.2, R30.1
unnamed: C16.1, L4.2, R28.2, R31.1
unnamed: C17.1, L5.2, R29.2, R32.1
unnamed: D6.1 (K), Q1.3 (C), Q4.1 (B), R24.1
unnamed: D6.2 (A), Q4.2 (E), Q7.1 (G)
unnamed: D7.1 (K), Q2.3 (C), Q5.1 (B), R25.1
unnamed: D7.2 (A), Q5.2 (E), Q8.1 (G)
unnamed: D8.1 (K), Q3.3 (C), Q6.1 (B), R26.1
unnamed: D8.2 (A), Q6.2 (E), Q9.1 (G)
unnamed: D9.1 (K), L3.1, Q7.3 (D)
unnamed: D10.1 (K), L4.1, Q8.3 (D)
unnamed: D11.1 (K), L5.1, Q9.3 (D)
OPAMP_B_P: C19.1, R31.2; also elsewhere on the board
OPAMP_G_P: C20.1, R32.2; also elsewhere on the board
OPAMP_R_P: C18.1, R30.2; also elsewhere on the board
PWM_B: C13.2, R22.2; also elsewhere on the board
PWM_G: C14.2, R23.2; also elsewhere on the board
PWM_R: C12.2, R21.2; also elsewhere on the board
V20: Q4.3 (C), Q5.3 (C), Q6.3 (C), Q7.2 (S), Q8.2 (S), Q9.2 (S), R24.2, R25.2, R26.2; also elsewhere on the board

Notes on the sheet:
Low-Pass Filter ----------------------- fcutt,off=1.539 kHz fsample=4 kHz

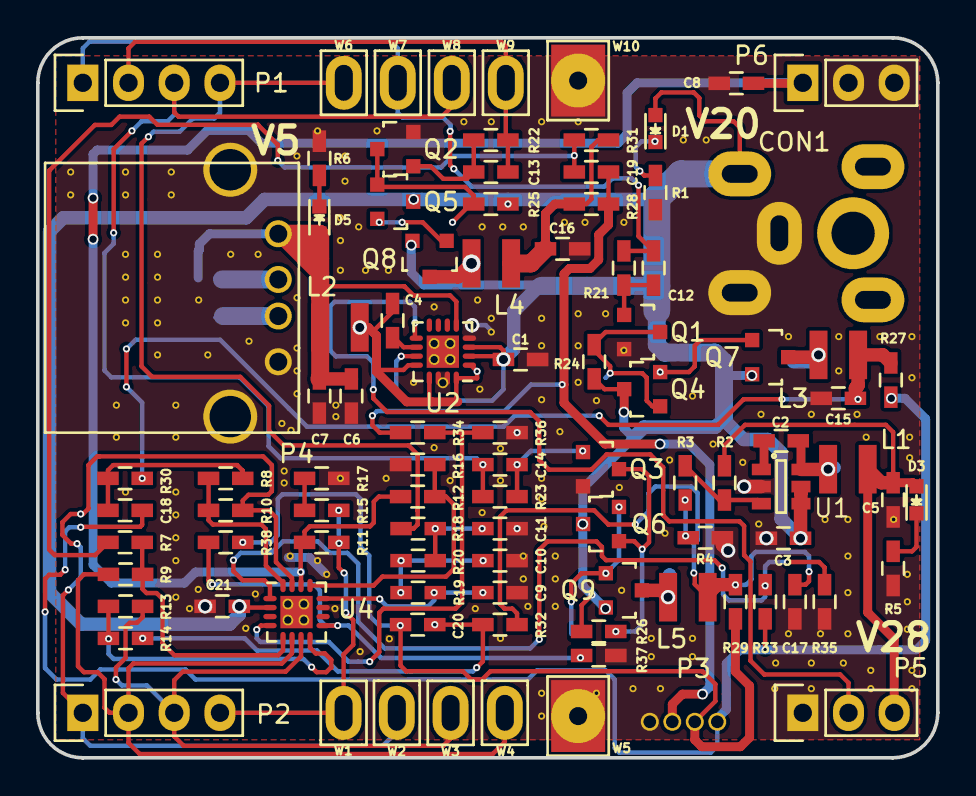
[picture p54: board power.kicad_pcb from above]

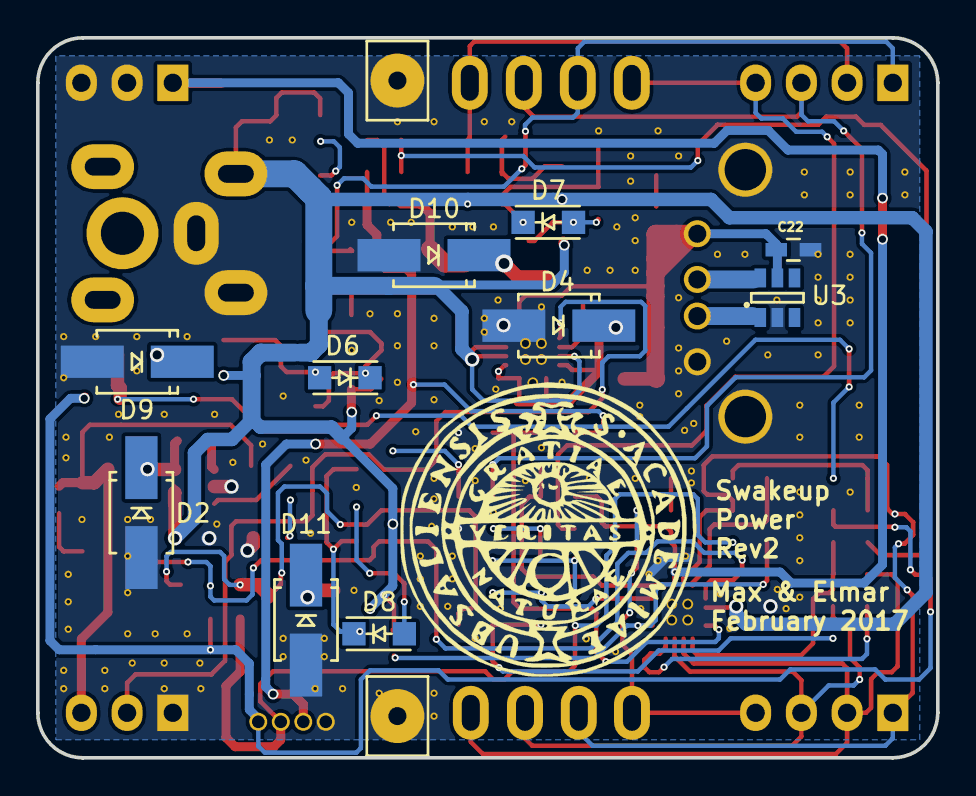
[picture p55: board power.kicad_pcb from below]

Board: 2 copper layers, 50.0 x 40.0 mm, 106 parts (10 on the bottom side), 57 nets.
