m3x1m0m/SwakeUp/code/xmega/modules/image.h

/*
 * image.h
 *
 * Created: 2/25/2017 10:10:50 PM
 *  Author: elmar
 */


#ifndef IMAGE_H_
#define IMAGE_H_



/*
 * BMP image data converted from 24bpp
 * to RGB565
 */

#include <avr/pgmspace.h>
#include <stdint.h>

/*
 * BMP image data converted from 24bpp
 * to RGB565
 */

const uint16_t imag1[] PROGMEM = {0x0914, 0x0113, 0x0113, 0x0113, 0x0112, 0x0112, 0x00f2, 0x00d1, 0x00f2, 0x00d2, 0x00b1, 0x0091, 0x00b1, 0x00d2, 0x00d2, 0x00d2, 0x00b1, 0x00b1, 0x0091, 0x0091, 0x00b1, 0x00b1, 0x0091, 0x00b1, 0x0071, 0x0090, 0x0070, 0x0070, 0x0070, 0x0070, 0x0090, 0x0070, 0x006f, 0x004f, 0x006f, 0x0070, 0x0070, 0x0070, 0x0070, 0x0070, 0x0090, 0x00b0, 0x00b0, 0x00b0, 0x00b0, 0x00d0, 0x00d0, 0x00d0, 0x00f1, 0x00f1, 0x00f1, 0x00f1, 0x00f1, 0x00f1, 0x00f1, 0x00f1, 0x00d1, 0x00f1, 0x00f1, 0x00f1, 0x00d1, 0x00d1, 0x00b0, 0x00b0, 0x008f, 0x008e, 0x006e, 0x004e, 0x004e, 0x002e, 0x002e, 0x002d, 0x004d, 0x004d, 0x002d, 0x002d, 0x002d, 0x002d, 0x002d, 0x002d, 0x002d, 0x002d, 0x002d, 0x002d, 0x004d, 0x004d, 0x004e, 0x004e, 0x004d, 0x004d, 0x004d, 0x004d, 0x004d, 0x004d, 0x004d, 0x004d, 0x002d, 0x002d, 0x002d, 0x004d, 0x004e, 0x004e, 0x004e, 0x004e, 0x004e, 0x004e, 0x004e, 0x004e, 0x002e, 0x002e, 0x002e, 0x002e, 0x004e, 0x004f, 0x0050, 0x0870, 0x006f, 0x006f, 0x006f, 0x008f, 0x0070, 0x0070, 0x006f, 0x008f, 0x008f, 0x00af, 0x00b0, 0x00b0, 0x00b1, 0x00b1, 0x00b1, 0x00d1, 0x00f1, 0x00f1, 0x00f2, 0x0112, 0x0133, 0x0133, 0x0933, 0x0954, 0x0974, 0x0994, 0x09b4, 0x09b4, 0x09d5, 0x09d5, 0x11f5, 0x1216, 0x1216, 0x1236, 0x1256, 0x1a76, 0x1276, 0x1a96, 0x1ab7, 0x22d7, 0x22d7, 0x22d6, 0x1ad7, 0x22d7, 0x0114, 0x0113, 0x00f3, 0x00f2, 0x0112, 0x0112, 0x0133, 0x0113, 0x0133, 0x0113, 0x00f3, 0x00d2, 0x00d2, 0x00d2, 0x00f2, 0x00f2, 0x00b1, 0x00d1, 0x00b1, 0x00b1, 0x0091, 0x0091, 0x0091, 0x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
, 0xbdb4, 0xb573, 0xb594, 0xbd94, 0xbd94, 0xbd94, 0xc5b5, 0xd617, 0xde38, 0xde78, 0xde78, 0xde98, 0xe699, 0xde98, 0xde98, 0xe6d9, 0xe6d9, 0xde98, 0xd657, 0xc616, 0xc5f6, 0xc5f6, 0xc617, 0xc638, 0xce59, 0xce79, 0xd67a, 0xdebb, 0xe6fc, 0xe6fc, 0xdefb, 0xe71c, 0xdefc, 0xdedc, 0xd6dc, 0xd6fc, 0xd6fd, 0xdf1d, 0xdefd, 0xe73e, 0xe6fc, 0xdedb, 0xdebb, 0xdedb, 0xdedb, 0xd69a, 0xce5a, 0xce39, 0xc5f9, 0xce39, 0xdedc, 0xe73c, 0xdedb, 0xd69a, 0xd69a, 0xe71c, 0xe71c, 0xe71c, 0xe71d, 0xe73d, 0xe71d, 0xe71c, 0xdefc, 0xdedc, 0xdedc, 0xdefc, 0xe71c, 0xe73d, 0xef5d, 0xef5d, 0xef5d, 0xd699, 0xce78, 0xd699, 0xdefa, 0xef5c, 0xef7c, 0xe6da, 0xd678, 0xd698, 0xd678, 0xd678, 0xd699, 0xdeda, 0xe71c, 0xe75d, 0xef5d, 0xef5e, 0xef7e, 0xf77e, 0xef5d, 0xe71c, 0xdedb, 0xce59, 0xc5f7, 0xc5f6, 0xc617, 0xc617, 0xc5f7, 0xbdd6, 0xbdd7, 0xc618, 0xce59, 0xd6bb, 0xdefc, 0xe71d, 0xdedc, 0xc65a, 0xbe19, 0xc67b, 0xdf1d, 0xe75e, 0xe77e, 0xe79f, 0xef9f, 0xef9f, 0xef7e, 0xe75e, 0xe73d};
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
