m3x1m0m/SwakeUp/code/esp/app/configuration.cpp

#include <application.h>
#include <configuration.h>
// If you want, you can define WiFi settings globally in Eclipse Environment Variables
#ifndef WIFI_SSID
#define WIFI_SSID "PleaseEnterSSID" // Put you SSID and Password here
#define WIFI_PWD "PleaseEnterPass"
#endif

SwakeConfig ActiveConfig;

SwakeConfig loadConfig() {
	StaticJsonBuffer<ConfigJsonBufferSize> jsonBuffer;
	SwakeConfig cfg;
	if (fileExist(THERM_CONFIG_FILE)) {
		int size = fileGetSize(THERM_CONFIG_FILE);
		char* jsonString = new char[size + 1];
		fileGetContent(THERM_CONFIG_FILE, jsonString, size + 1);
		JsonObject& root = jsonBuffer.parseObject(jsonString);

		JsonObject& network = root["network"];
		cfg.StaSSID = String((const char*) network["StaSSID"]);
		cfg.StaPassword = String((const char*) network["StaPassword"]);
		cfg.StaEnable = network["StaEnable"];
		cfg.city = String((const char*) network["city"]);
		cfg.date = String((const char*)network["date"]);
		cfg.time = String((const char*)network["time"]);
		cfg.alarmTime = String((const char*)network["alarmtime"]);
		cfg.alarmDays = network["alarmdays"];
		delete[] jsonString;
	} else {
		//Factory defaults if no config file present
		cfg.StaSSID = WIFI_SSID;
		cfg.StaPassword = WIFI_PWD;
		cfg.city = "Amsterdam";
		cfg.date = "2017/06/01";
		cfg.time = "01:30";
		cfg.alarmTime = "00:00";
		cfg.alarmDays = 0;
	}
	return cfg;
}

void saveConfig(SwakeConfig& cfg) {
	StaticJsonBuffer<ConfigJsonBufferSize> jsonBuffer;
	JsonObject& root = jsonBuffer.createObject();

	JsonObject& network = jsonBuffer.createObject();
	root["network"] = network;
	network["StaSSID"] = cfg.StaSSID.c_str();
	network["StaPassword"] = cfg.StaPassword.c_str();
	network["StaEnable"] = cfg.StaEnable;
	network["city"] = cfg.city;
	network["date"] = cfg.date;
	network["time"] = cfg.time;
	network["alarmtime"] = cfg.alarmTime;
	network["alarmdays"] = cfg.alarmDays;
	char buf[ConfigFileBufferSize];
	root.prettyPrintTo(buf, sizeof(buf));
	fileSetContent(THERM_CONFIG_FILE, buf);
}
