m3x1m0m/SwakeUp/code/xmega/drivers/host/spi.c

/*
 * spi.c
 *
 * Created: 2/1/2017 5:25:38 PM
 *  Author: elmar
 */
#include "spi.h"
#include <avr/io.h>
#include <avr/interrupt.h>
#include "../../pin_definitions.h"
#include "../../modules/log.h"

LOG_INIT("SPI");

uint8_t spi_write_blocked(uint8_t byte) {
    SPIC.DATA = byte;  //send it
    while (!(SPIC.STATUS & SPI_IF_bm)); //wait for the transfer to end
    return 1;
}
uint8_t spi_writes_blocked(uint8_t * bytes, uint8_t len) {
    uint8_t i;
    for (i = 0; i < len; i++) {
        SPIC.DATA = bytes[i];  //send it
        while (!(SPIC.STATUS & SPI_IF_bm)); //wait for the transfer to end
    }
    return 1;
}

static uint8_t init(void) {
    //1101 0000
    SPIC_PORT.DIRSET = SPIC_SCK | SPIC_MOSI | SPI_SS;
    SPIC_PORT.PIN4CTRL = PORT_OPC_WIREDANDPULL_gc; // wired AND & pull-up
    SPIC_PORT.DIRCLR = SPIC_MISO;
    SPIC_PORT.PIN6CTRL = PORT_OPC_PULLDOWN_gc;
    //out C5: DATA ABC (MOSI) d10
    //in C6: not active input (MISO)
    //out C7: DATA zegar (SCK) d21
    SPIC.CTRL = 0xD0;
    //SPIC.INTCTRL |= SPI_INTLVL_LO_gc;  //set interrupts
    SPIC.STATUS;    //both these are to take IF down
    SPIC.DATA;  //when I don't use interrupts
    LOG_SYSTEM("SPI initialized");
    return 1;
}
static uint8_t deinit(void) {
    return 1;
}
MODULE_DEFINE(SPI, "SPI", init, deinit);
