m3x1m0m/SwakeUp/code/xmega/drivers/host/timer.h

/*
 * timer.h
 *
 * Created: 11/14/2016 1:11:16 AM
 *  Author: elmar
 */


#ifndef TIMER_H_
#define TIMER_H_

#include "../../util/event.h"
#include "../../util/module.h"

/////////////////////////////////////////////////////////////////////////////////
// Defines
/////////////////////////////////////////////////////////////////////////////////
#define TICK_1KHZ 250-1;
#define TICK_100HZ 2500-1;

/////////////////////////////////////////////////////////////////////////////////
// Event export
/////////////////////////////////////////////////////////////////////////////////
EVENT_EXP(EVENT_TIMER_1_HZ);
EVENT_EXP(EVENT_TIMER_10_HZ);
EVENT_EXP(EVENT_TIMER_100_HZ);
EVENT_EXP(EVENT_TIMER_1000_HZ);
EVENT_EXP(EVENT_ALARM);

/////////////////////////////////////////////////////////////////////////////////
// Prototypes
/////////////////////////////////////////////////////////////////////////////////
uint16_t timer_runTime(void);
int8_t   timer_timeOutEvent(uint16_t duration);

MODULE_EXP(TIMER);

#endif /* TIMER_H_ */
