m3x1m0m/SwakeUp/code/xmega/modules/command.h

/*
 * command.h
 *
 * Created: 2/8/2017 11:29:04 PM
 *  Author: elmar
 */


#ifndef COMMAND_H_
#define COMMAND_H_

#include "../util/module.h"

uint8_t command_next_arg(char *data, uint8_t len);
uint8_t command_arguments(char *data, uint8_t len);
char command_next_char(uint8_t * index, char * string, uint8_t size);
uint32_t command_next_int(uint8_t * index, char * string, uint8_t size);
uint8_t command_hook(char command, void (* callback)(uint8_t, char *));
uint8_t command_hook_description(char command, void (* callback)(uint8_t, char *), char * description);
uint8_t command_remove(char command, void (* callback)(uint8_t, char *));
void command_remove_force(char command);

MODULE_EXP(COMMAND);


#endif /* COMMAND_H_ */
