m3x1m0m/SwakeUp/(commit log)

2016-11-11 Added USB Charger to blockdiagram.
2016-11-14 UART should work with interrupts now... should
2016-11-14 migrating to a pin definitions file, much better
2016-11-14 pin definitions work
2016-11-14 first commit of the timer, needs a lot of work. Is a 1 second timer now
2016-11-14 Start of SPI with interrupt
2016-11-14 Fixed the event, also made UART a module
    [uart.c, uart.h]
2016-11-14 Fixed critical UART bug, now works on interrupt basis as well
    [log.c, log.h, pin_definitions.h, uart.c]
2016-11-14 Started working on a PWM module.
2016-11-14 added some error logging, test for power down mode (not sure if works)
2016-11-15 Uart is a little less static, works on 1,8 and 16 mHz. defaults to 9600 baud on 1, 38400 on 8 and 16
2016-11-16 Toggle of ERROR pin to debug sleep and waking up
2016-11-17 Start with altium
    [SwakeUpp.PrjPcb, atxmega.PcbDoc, atxmega.SchDoc]
2016-11-18 Schematics finished, general placement of components in design
    [SwakeUpp.PrjPcb, atxmega.PcbDoc, atxmega.SchDoc]
2016-11-18 moved files to the intended location
    [SwakeUpp.PrjPcb, atxmega.PcbDoc, atxmega.SchDoc]
2016-11-18 Started with BOM. Added some datasheets.
    [bom_power.ods]
2016-11-18 Finished placement of components, almost done with routing
    [atxmega.PcbDoc, atxmega.SchDoc]
2016-11-18 Project settings
    [SwakeUpp.PrjPcb]
2016-11-18 Rev1 routed and finished
    [SwakeUpp.PrjPcb, atxmega.PcbDoc, atxmega.SchDoc]
2016-11-21 Finalized PCB
    [SwakeUpp.PrjPcb, atxmega.PcbDoc, atxmega.SchDoc]
2016-11-21 Bom with all parts except for LCD
    [Bom_SwakeUpp.xls.xlsx]
2016-11-23 Forgot some minor routing. Hooked up some signals to vcc according to datasheet
    [atxmega.PcbDoc, atxmega.SchDoc]
2016-11-23 This really is important for the timer so that it can be used with different cpu frequencies
2016-11-24 PCB stuff.
    [bom_power.ods, led_driver_red.sch, power_main.sch]
2016-11-24 Finished LED Driver.
    [bom_power.ods, ledDriverR.sch, led_driver_red.sch, power.kicad_pcb, power.sch, power_main.sch, rgbLedDriver.sch]
2016-11-26 Finished LED Driver with Feedback and OLED Driver.
    [bom_power.ods, power.sch, rgbLedDriver.sch]
2016-11-26 Finished driver for 2.8 V.
    [V28.sch, power.sch, rgbLedDriver.sch]
2016-11-27 Almost finished 5V bucket converter. Found nice IC.
    [V28.sch, V53A.sch, power.sch, rgbLedDriver.sch]
2016-11-28 Finished almost everything in the schematic. Missing: Interfacing with elmare and the correct power connector for the 20 V power supply.
    [V28.sch, V53A.sch, power.sch]
2016-11-28 Almost done with the schematics. Some fine tuning is left.
    [V28.sch, V53A.sch, power.sch, rgbLedDriver.sch]
2016-11-30 Added power save pin
    [atxmega.PcbDoc, atxmega.SchDoc]
2016-12-01 Finished schematics.
    [power.sch, rgbLedDriver.sch]
2016-12-01 Checked all comp. of the LED Driver once more and assigned footprints.
    [power.sch, rgbLedDriver.sch]
2016-12-01 Worked on the Barrel Jack mainly, bought also a matching power supply. Nice!
    [power.sch]
2016-12-01 Added some more footprints. Maybe have to change some grounding stuff.
    [power.sch, rgbLedDriver.sch]
2016-12-02 All footprints assigned. No DRC errors anymore.
    [power.sch, rgbLedDriver.sch]
2016-12-02 Finished the schematics.
    [bucketConvs.sch, leds.sch, measurePoints.sch, power.sch, rgbLedDriver.sch]
2016-12-02 Started layouting. Interfacing problems have to be discussed.
    [leds.sch, power.kicad_pcb, power.sch]
2016-12-06 Started placing some components.
    [bucketConvs.sch, leds.sch, measurePoints.sch, power.kicad_pcb, power.sch, rgbLedDriver.sch]
2016-12-11 Finished both bucket converters.
    [bucketConvs.sch, power.kicad_pcb]
2016-12-22 Did a lot of stuff. Currently working on the exact 3D models for the headers.
    [ESQ-103-12-G-S-LL.stp, bucketConvs.sch, leds.sch, measurePoints.sch, power.kicad_pcb, power.sch, rgbLedDriver.sch]
2016-12-23 Almost finished routing.
    [ESQ-103-12-G-S-LL.stp, power.kicad_pcb, power.sch]
2016-12-24 Finished layout.
    [power.kicad_pcb]
2016-12-25 Finished the layout. Could be produced like that. Some fine tuning will maybe be done if I see something, which bothers me.
    [power.kicad_pcb]
2016-12-26 Fnished board. Producing output now.
    [power.kicad_pcb]
2016-12-26 Added some stitching vias.
    [power.kicad_pcb]
2016-12-26 Added gerber output.
    [power-B.CrtYd.gbr, power-B.Cu.gbr, power-B.Mask.gbr, power-B.SilkS.gbr, power-Edge.Cuts.gbr, power-F.CrtYd.gbr, power-F.Cu.gbr, power-F.Mask.gbr]
2016-12-26 Only thing missing now in the 3D model is one diode type.
    [power.kicad_pcb]
2016-12-29 Better planning next time! This should be Rev1
    [atxmega.PcbDoc, atxmega.SchDoc]
2016-12-30 Started completely over with the layout, as the OLED would not fit anymore. Also introduced a USB DCP Controller and found a stupid bug in the LED driver.
    [bucketConvs.sch, leds.sch, measurePoints.sch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]
2016-12-30 Fixed the bug. Now workin with differential amplifiers. Started over once more with the layout.
    [bucketConvs.sch, leds.sch, measurePoints.sch, power.kicad_pcb, power.sch, rgbLedDriver.sch]
2017-01-01 Finished the layout almost (third time). Some via stitching still has to be done. Taking a look at heat disipation, too.
    [power.kicad_pcb, power.sch]
2017-01-03 Finished rev 1 and generated gerber files.
    [measurePoints.sch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]
2017-01-12 Finished up rev 1. Also added is a bom
    [Bom_SwakeUpp.xlsx, SwakeUpp.PrjPcb, atxmega.PcbDoc]
2017-01-26 Fixed a bug.
    [bucketConvs.sch, leds.sch, measurePoints.sch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]
2017-01-28 Organizing the PCB's
    [Bom_SwakeUpp.xls.xlsx, Bom_SwakeUpp.xlsx, SwakeUpp.PrjPcb, atxmega.PcbDoc, atxmega.SchDoc]
2017-01-29 Adjusted the RX and TX paths
    [atxmega.PcbDoc, atxmega.SchDoc]
2017-01-29 UART ports are fully rerouted
    [atxmega.PcbDoc]
2017-01-29 Stop generating rooms
    [SwakeUpp.PrjPcb]
2017-01-29 Moved PWM channels so only one perihperal is needed for pwm pins instead of 2
    [atxmega.PcbDoc, atxmega.SchDoc]
2017-01-30 Making use of the RTC, not that efficient yet. But 1Hz works again
2017-01-30 Removed the led debug
2017-01-30 Led blink on interrupt with sleep works again
2017-01-30 Start of REV version so old boards will keep working
2017-01-31 Interrupt works now, also added extra baudrate options
2017-02-02 Produced some output. Merge with master.
    [bucketConvs.sch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]
2017-02-08 uart reading. has yet to be tested.
2017-02-15 Fixed the board. This is rev 2.
    [leds.sch, power.kicad_pcb, rgbLedDriver.sch]
2017-02-16 Some minor changes. Rev2 ready now.
    [power.kicad_pcb]
2017-02-18 Produced some output. Soldermask changed: Less clearance.
    [power-B.Cu.gbl, power-B.Mask.gbs, power-B.SilkS.gbo, power-Edge.Cuts.gm1, power-F.Cu.gtl, power-F.Mask.gts, power-F.SilkS.gto, power.drl]
2017-02-23 Command + test case
2017-02-23 Start on esp driver
2017-02-23 Screen is too broad, narrowed it down to the screen driver name. Also included <avr/io.h> not sure if this is a brilliant idea
2017-02-23 In the works, does not work yet
    [spi.c, spi.h]
2017-02-23 Added a lock while writing, prevents corruption. Removed some arguments. Solved a bug with the reading of data
    [uart.c, uart.h]
2017-02-23 Adjusted to work with the new uart.h
2017-02-24 Spi works now
2017-02-24 Screen driver seems to work so far, still needs performance adjustments
2017-02-25 Made some things constant and static Macro for generating interrupt vectors
2017-02-26 Added a sink, and a timer during debug (seconds, should become miliseconds)
2017-02-26 We can now log to the screen instead of uart
2017-02-26 in progress: interrupt based SPI
2017-02-26 Added const and solved simple bug
    [uart.c]
2017-02-26 request current sink
2017-02-26 Still working and failling on interrupt based spi
    [spi.c, spi.h]
2017-02-27 we can now switch between screen and uart with commands
2017-02-28 We can receive ESP messages now! Investigate crash upon /r/n
    [esp8266.c]
2017-02-28 Stops the system upon error
    [log.c, log.h]
2017-03-02 Fixed the log routine and added functions for reading of flash
    [log.c, log.h]
2017-03-02 Fixed the log routine and added functions for reading of flash omitted warnings
    [terminal.c, terminal.h]
2017-03-02 Fixed drawing sub image, fixed drawing text
    [screen.c]
2017-03-06 Cleaned a bit and added a report.
    [Bom_SwakeUpp.xlsx, bom_power.ods]
2017-03-06 Whoops. Forgot to track a directory.
    [shit.ods]
2017-03-08 start of presentation. Powerpoint. Sorry max
2017-03-09 Switching from screen terminal to uart terminal works now. Setting time reflects to the clock app.
2017-03-09 Weird bug with drawing text
    [screenterminal.c]
2017-03-09 if we ever get to use 8 bits per color, this is fixed now
    [screen.h]
2017-03-09 Came quite far with the report.
    [bucketConvs.sch, leds.sch, measurePoints.sch, power.sch, rgbLedDriver.sch, shit.ods]
2017-03-09 Finalized logic explanation. Its terrible
    [SwakeUpp.PrjPcb, atxmega.SchDoc]
2017-04-24 Further integration of the stream. Separation of callbacks for the uart.
2017-04-26 Debugging, and omitted a crash
    [esp8266.c]
2017-04-27 Quick fix for the protobuf error, should be investigated further when time allows
    [control.c]
2017-04-27 More indepht information for the UART streams
2017-04-27 Minor bug fixes, a lot of warnings omitted
    [SEPS525F.c, clock.c, command.c, control.c, core.c, esp8266.c, msgproc.c]
2017-05-03 Workaround for the max outgoing stream size, should be added to constructor maybe
    [ProtoStream.h]
2017-05-04 Minor changes.
    [bucketConvs.sch, leds.sch, measurePoints.sch, power.sch, rgbLedDriver.sch]
2017-05-04 Fixed problems with board.
    [bucketConvs.sch, leds.sch, measurePoints.sch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]
2017-05-04 Started with the PWM.
2017-05-04 Tried to get PWM working. Does not work yet.
    [pwm.c, pwm.h]
2017-05-05 PWM inc. high resolution ext. is running.
2017-05-05 All PWM channels working. Terminal interaction possible. Need to fix some smaller things.
    [core.c, pwm.c, pwm.h]
2017-05-08 Simulated a bit.
    [PWM_PER_Values.ods]
2017-05-10 Simulated a bit more.
    [bucketConvs.sch, leds.sch, measurePoints.sch, power.sch, rgbLedDriver.sch]
2017-05-10 ADC is running. Accuracy is not satisfying yet.
2017-05-11 Moved pin definitions. Started with PID.
2017-05-11 Fixed PID problem.
2017-05-11 Ugly workaround for some communication issue (integer too large)
    [pb_decode.c]
2017-05-12 Important fix for the screen
    [pin_rev_2.h]
2017-05-12 Almost finished the new schematics.
    [bucketConvs.sch, leds.sch, measurePoints.sch, power.sch, rgbLedDriver.sch]
2017-05-13 Improved timekeeper, keeps track of date as well. Now fires update event
2017-05-13 Small typo, fixed AM PM
    [timekeeper.c]
2017-05-14 Quick and UGLY hotfix. Waiting for next SMING release to revert this
    [pb_decode.c]
2017-05-14 Dirty fix for the string to work, should be out by the next version
    [pb_decode.c]
2017-05-15 Got ADC up and running interupt based.
2017-05-15 Updated app layer with new and exciting features for development. Also fixed stackoverflow error in the mail app
    [app.h, clock.c, clock.h, console.c, core.c, core.h, mail.c, status.c]
2017-05-15 Made ADC code more elegant (shorted LOCs).
    [adc.c, adc.h, pin_rev_2.h]
2017-05-15 Finished adc driver. Have to test it tomorrow.
2017-05-16 TCC0 giving now an interrupt to trigger an event every 100 Hz.
2017-05-16 Started with the PID.
2017-05-16 Fixed the console to work after disabling it again
    [console.c]
2017-05-17 Added a custom fixed point lib.
    [pid.c, pid.h]
2017-05-18 Got REV1 working. Dirty fix, which needs to be improved.
    [adc.c, adc.h, defines.h, pid.c, pid.h, pin_rev_2.h]
2017-05-18 PID controller is working. P,I and D parts are working. Making it easier accessible now for higher layers.
2017-05-18 Part of the webserver integrated, city can now be set via web browser
    [configuration.h]
2017-05-21 Updated with new site layout, TODO: add the alarm list
    [configuration.h]
2017-05-23 PID infrastructure works.
2017-05-24 Wrote a module for light pattern. Moved PID in the module dir.
2017-05-25 Cleaned SPI
2017-05-31 Added PID script and curves.
2017-05-31 Updated the esp files to reflect the website better
    [configuration.h]
2017-05-31 Added a newer schematics version.
2017-05-31 Wrote something about PWM and ADC.
2017-05-31 Added figures and written implementations/logic board
2017-06-28 Added alarm support
    [configuration.h]
2017-11-13 Produced gerber files.
    [leds.sch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]
